segs03-tamu/ECEN404-2025SP-Fantastic-Foxbot/presentation_slides/404 Statues Update 1.pdf

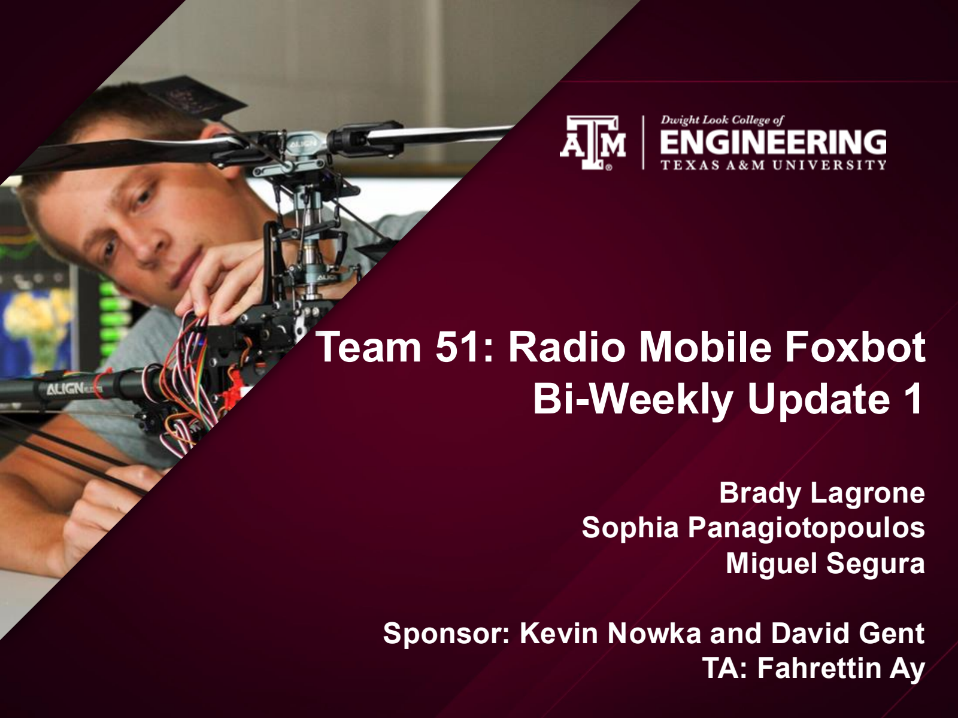
[picture p20: page 1]

# Team 51: Radio Mobile Foxbot Bi-Weekly Update 1

### Brady Lagrone Sophia Panagiotopoulos Miguel Segura

### Sponsor: Kevin Nowka and David Gent TA: Fahrettin Ay

# Project Summary

Purpose:
- Amateur Radio Directional Finding (ARDF) is traditionally done with a stationary transmitter, limiting the training abilities.
- Transmitted signals are non-adjustable with little variability for the user.
Our Proposal:
- We will have a mobile robot chassis transmitting user selected signals.
- This will increase the potential of ARDF training.

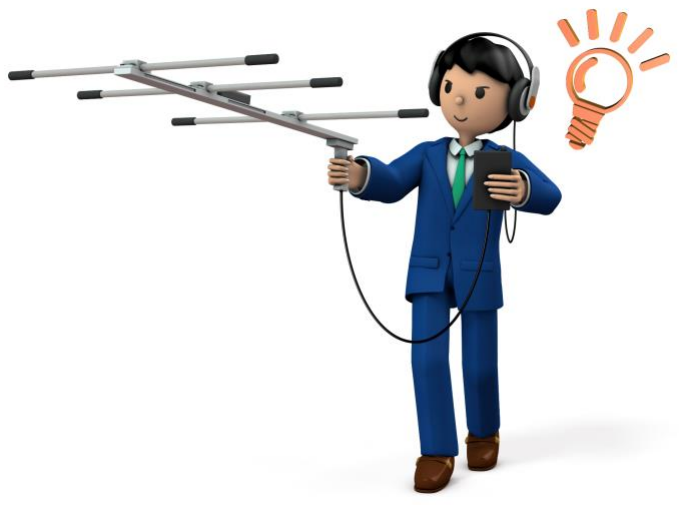
[picture p21: figure]

# Project/Subsystem Overview

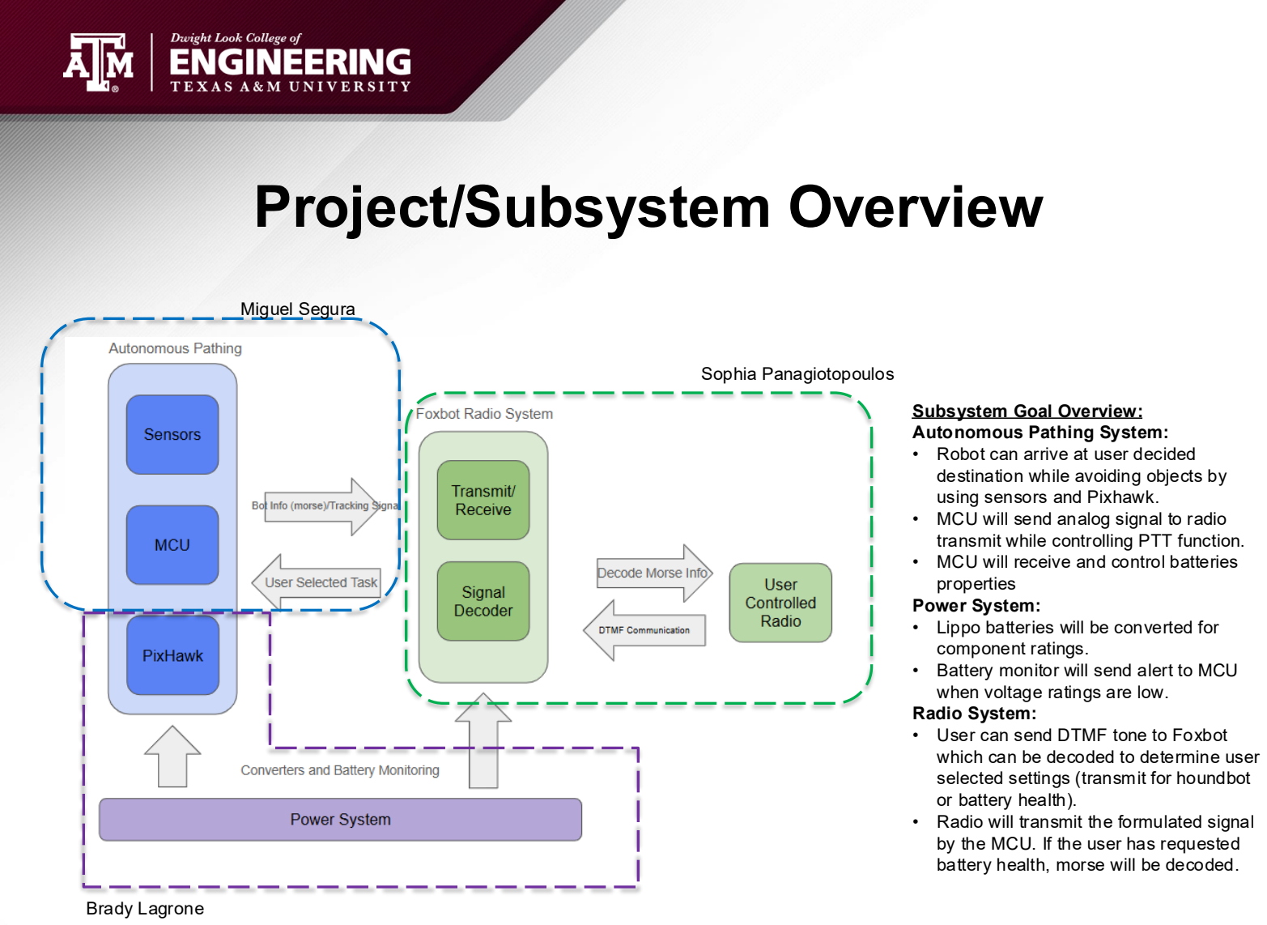
[picture p22: page 3]

Brady Lagrone

Sophia Panagiotopoulos

Miguel Segura

Subsystem Goal Overview:
Autonomous Pathing System:
- Robot can arrive at user decided destination while avoiding objects by using sensors and Pixhawk.
- MCU will send analog signal to radio transmit while controlling PTT function.
- MCU will receive and control batteries properties
Power System:
- Lippo batteries will be converted for component ratings.
- Battery monitor will send alert to MCU when voltage ratings are low.
Radio System:
- User can send DTMF tone to Foxbot which can be decoded to determine user selected settings (transmit for houndbot or battery health).
- Radio will transmit the formulated signal by the MCU. If the user has requested battery health, morse will be decoded.

# Major Project Changes for 404

Major Project Changes: Decided on using a singular ESP instead of 2
- Initially, we had an ESP for pathing and an ESP for battery monitors and radio, but interfacing the ESPs seems out of reach between system integration and our timeline.

Autonomous Pathing System:
- Motor Driver will be directly connected to the Pixhawk and not to the ESP32
- Pixhawk connects to the ESP32 to specifically read values from the ultrasonic sensors

Power System:
- Battery will be monitored by fuel gauge and will send information to and from the ESP using the SCL and SDA lines.

Radio System:
- Going to use a morse decoder app instead of trying to make one.
- Will receive battery information only, where we initially were also going to do coordinates of the Foxbot.

# Project Timeline

Completed

- Ultrasonic
sensor
programming
with ESP
- DTMF
Decoder and
transmission
circuit
- Voltage
converters for
each
component
- Mission plan
from EQUAD
to Kyle Field
- Pixhawk
interfacing
with motors
- Battery
monitor
design
- ESP code for
transmission
and battery
monitor
readings
- Integrate the
battery
monitor with
the radio
system to
transmit data
to the user
- Sensors
connected to
Pixhawk for
autonomous
pathing
Underway | Future

# MCU Subsystem

Miguel Segura

Accomplishments since 403 ~8hrs | Ongoing progress/problems and plans until the next presentation
- Reformatted and adjusted the motor control and ultrasonic sensor code that was done in 403. | • Connect Sabertooth 2x12 to the PixHawk and Mission Planner for the autonomous control. • Connect the US sensors to the PixHawk and provide functionality with the code created. • Create firmware that integrates the Radio Subsystem to the ESP32.

# MCU Subsystems

Miguel Segura

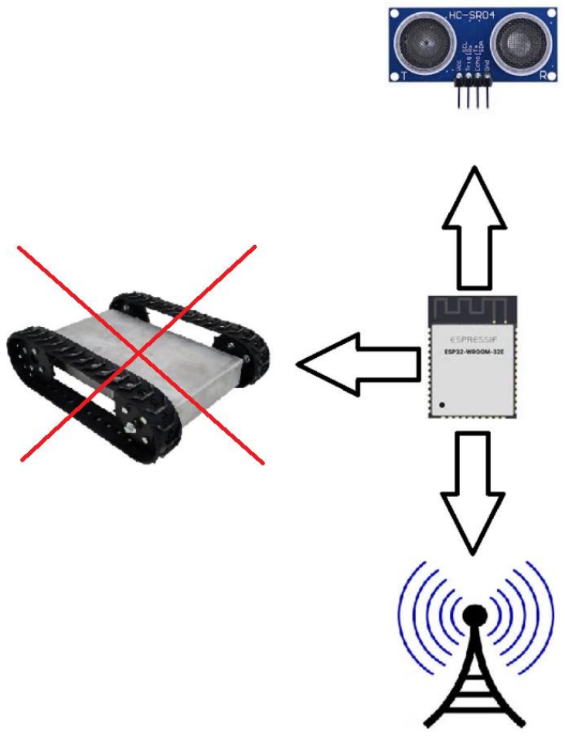
[picture p23: figure]

- ESP32 no longer directly connecting to the Foxbot's motors
- Ultrasonic sensor code
works but needs to
connect to the PixHawk.
- Code for radio/esp32
needs to be programmed
to transmit.

# Power Subsystem

Brady Lagrone

Accomplishments since 403
~15 hours

Ongoing progress/problems and plans until the next presentation
- Three step down converters (3.3V, 5.3V, 7.4V) from 11.1V are still operational from 403
- Working I2C communication (Between ESP32s for now)
- Have basic inputs to ESP32 ADC to output into morse (LED)
- Work with Radio Subsystem to connect the ESP32 dev kit to PCB and start testing binary inputs to functions
- ESP32 connect to battery fuel gauges or look into other options

# Power Subsystem

Brady Lagrone

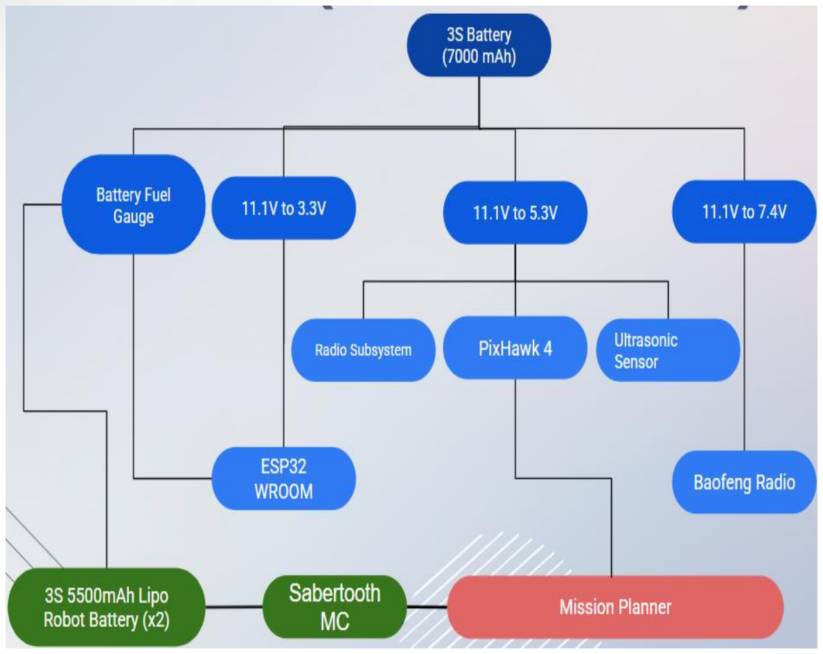
[picture p24: figure]

- Power converters all work at their respective voltage out levels and max current draws.
- Mission planner can handle control of motors.
- ESP32 has basic morse code outputs

# Radio Subsystem

Sophia Panagiotopoulos

Accomplishments since 403
~20 hrs of effort

Ongoing progress/problems and plans until the next presentation
- Decoder and transmission perform as I left it in 403; decoder properly can identify the DTMF tone sent and, PTT can be
enabled by a common ground, and the Foxbot radio can transmit to the user radio via a sinusoidal wave.
- Designed and simulated a condensed output line for easier ESP integration
- Enable PTT with a transistor, controlled by a GPIO pin.
- Send signals from DAC to user radio.
- Finalize ESP pins and map out on integrated schematic.
- Designing MUX configuration to condense I2C lines for the battery monitor integration with ESP

# Radio Subsystem Figure

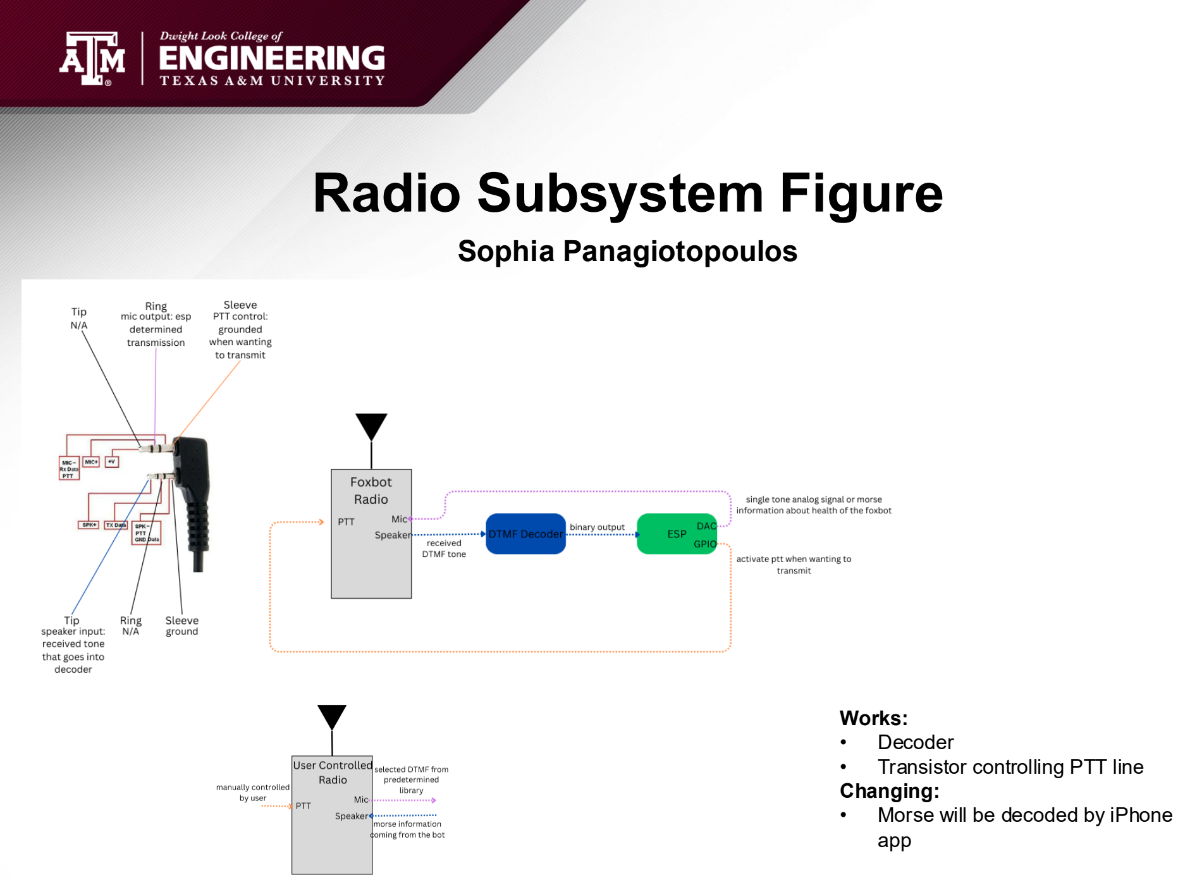
[picture p25: page 11]

Sophia Panagiotopoulos

Works:
- Decoder
- Transistor controlling PTT line Changing:
- Morse will be decoded by iPhone app

# Parts Ordering Status

- Working on making the integrated PCB and plan to get that finished by early February.
- Assembly will start once all parts have come in

# Validation Plan

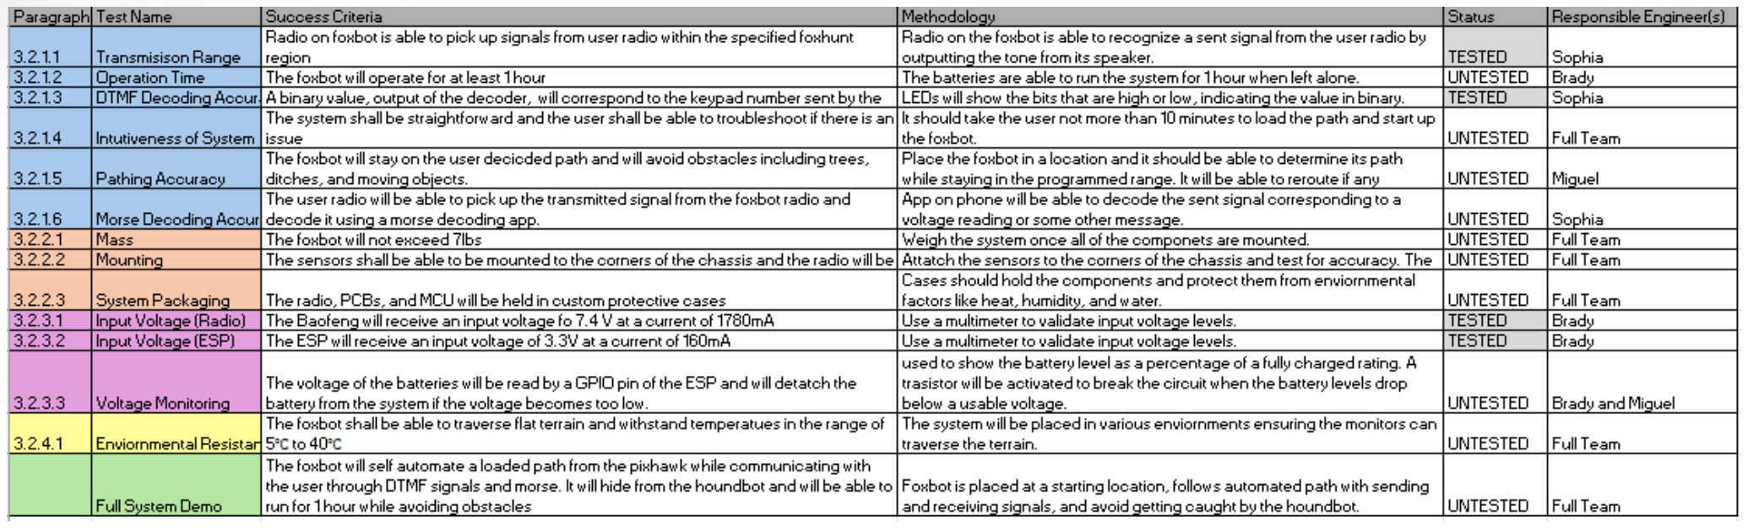
[picture p26: figure]

# Gantt Chart

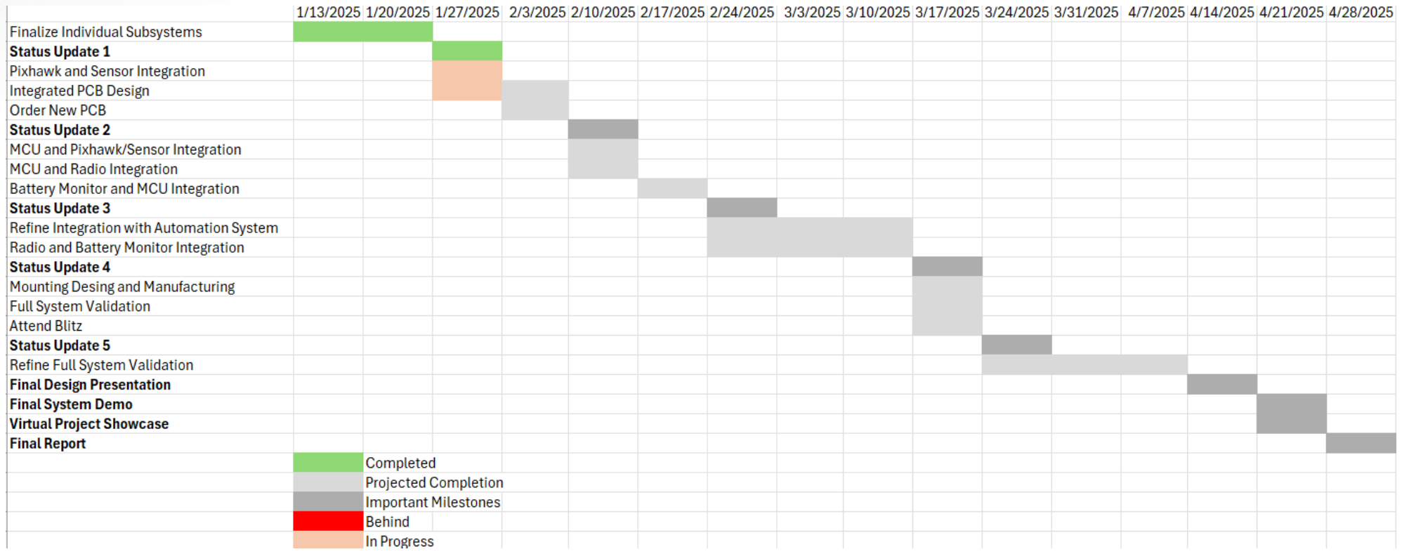
[picture p27: figure]
