segs03-tamu/ECEN404-2025SP-Fantastic-Foxbot/presentation_slides/404 Status Update 2.pdf

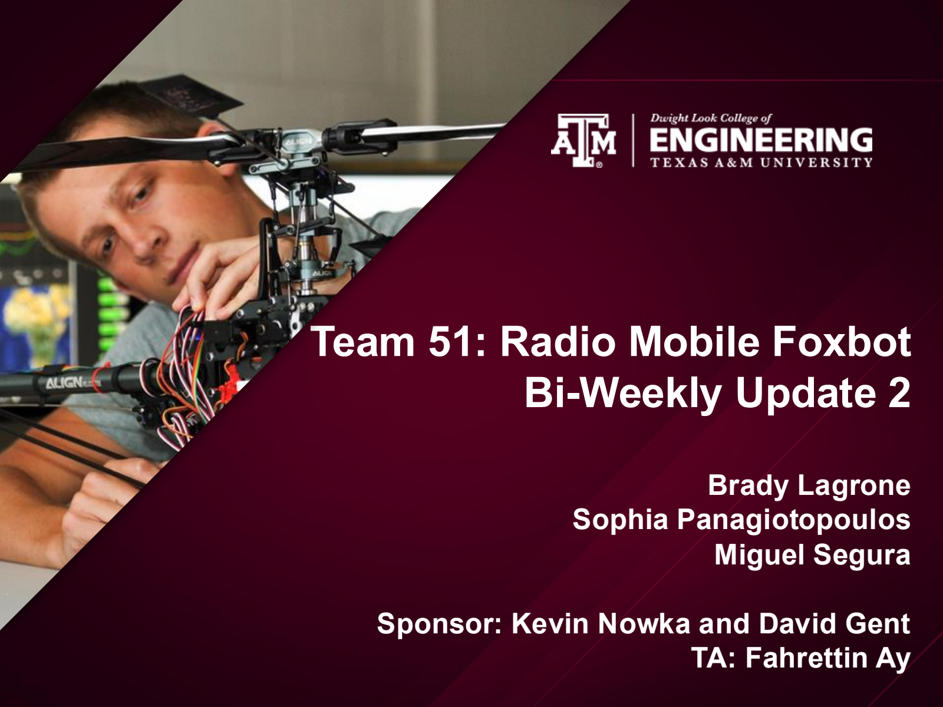
[picture p28: page 1]

# Team 51: Radio Mobile Foxbot Bi-Weekly Update 2

### Brady Lagrone Sophia Panagiotopoulos Miguel Segura

### Sponsor: Kevin Nowka and David Gent TA: Fahrettin Ay

- Purpose:
- Amateur Radio Directional Finding (ARDF) is traditionally done with a stationary transmitter, limiting the training abilities.
- Transmitted signals are non-adjustable with little variability for the user.
- Our Proposal:
- We will have a mobile robot chassis transmitting user selected signals.
- This will increase the potential of ARDF training.

# Project Summary

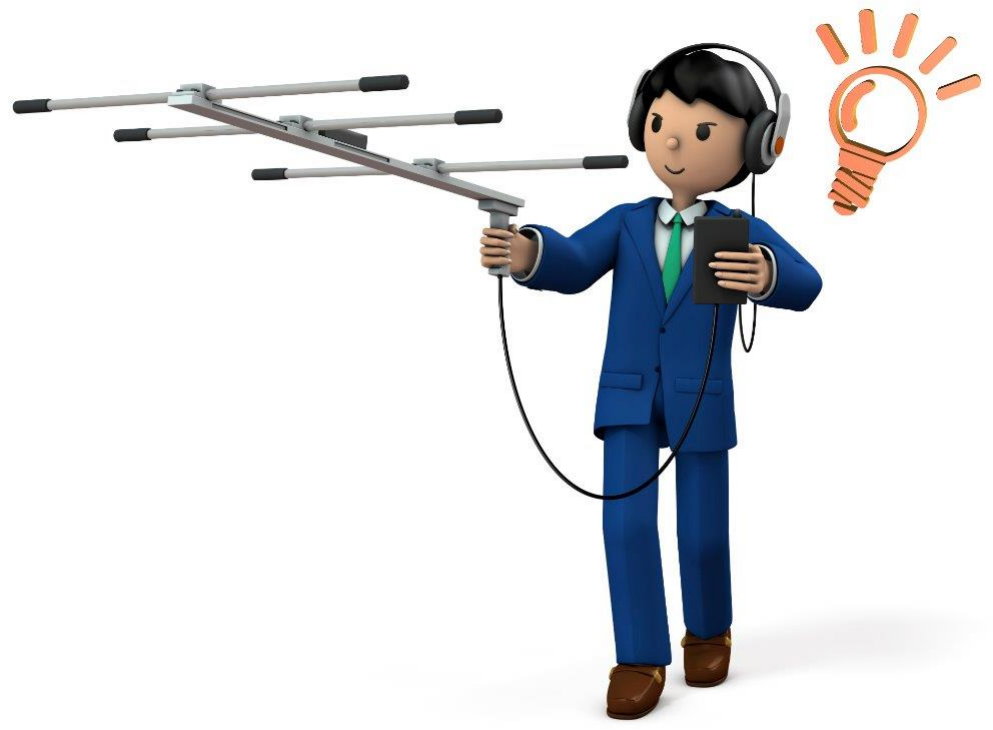
[picture p29: figure]

# Project/Subsystem Overview


Brady Lagrone

Sophia Panagiotopoulos

Miguel Segura

Subsystem Goal Overview:
Autonomous Pathing System:
- Robot can arrive at user decided destination while avoiding objects by using sensors and Pixhawk.
- MCU will send analog signal to radio transmit while controlling PTT function.
- MCU will receive and control batteries properties
Power System:
- Lippo batteries will be converted for component ratings.
- Battery monitor will send alert to MCU when voltage ratings are low.
Radio System:
- User can send DTMF tone to Foxbot which can be decoded to determine user selected settings (transmit for houndbot or battery health).
- Radio will transmit the formulated signal by the MCU. If the user has requested battery health, morse will be decoded.

# Project Timeline

Subsystem
Designs and
Testing
(completed
01/27)

Integration of
power and
radio
subsystem
PTT
(completed
2/9)

Integration of
MCU and
Motor Driver
(to complete
by 2/14)

Integration of
power and
radio ADC
(to complete
by 2/14)

Final
Integration(to
complete by
3/7)

System
Testing (to be
completed
3/17)

Demo and
Report
(to complete
by 4/14)

# MCU Subsystem

Miguel Segura

Accomplishments since last update ~16 hrs of effort

Ongoing progress/problems and plans until the next presentation

- Armed the PixHawk to Mission Planner to provide the
autonomous design.
- Wrote code to make LEDs
interact as "motors" to measure their PWM signal from Mission Planner through the PixHawk.
- Integrate PixHawk to Sabertooth and perform test runs through Mission Planner
- Further develop simulation protocol and get functionality across the system.

# MCU Subsystem

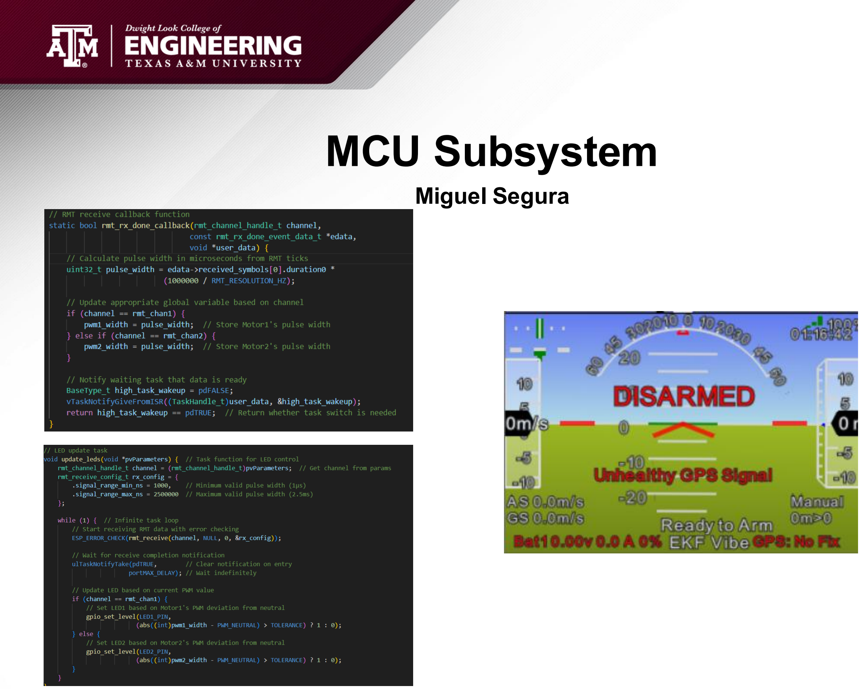
[picture p30: page 6]

Miguel Segura

# Power Subsystem

Brady Lagrone

Accomplishments since last update 30 hrs of effort

Ongoing progress/problems and plans until the next presentation
- Established I2C communication with BQ7692003PWR battery
monitor
- Wrote and tested code for the ADC detecting levels 0-9, for integrating with the radio subsystem
- Wrote code for to produce morse code from the generated sine wave, and tested and integrated with radio subsystem
- Continue and finish PCB
integration between power and radio subsystem
- Establish more modes of
operation according to digits pressed

# Power Subsystem

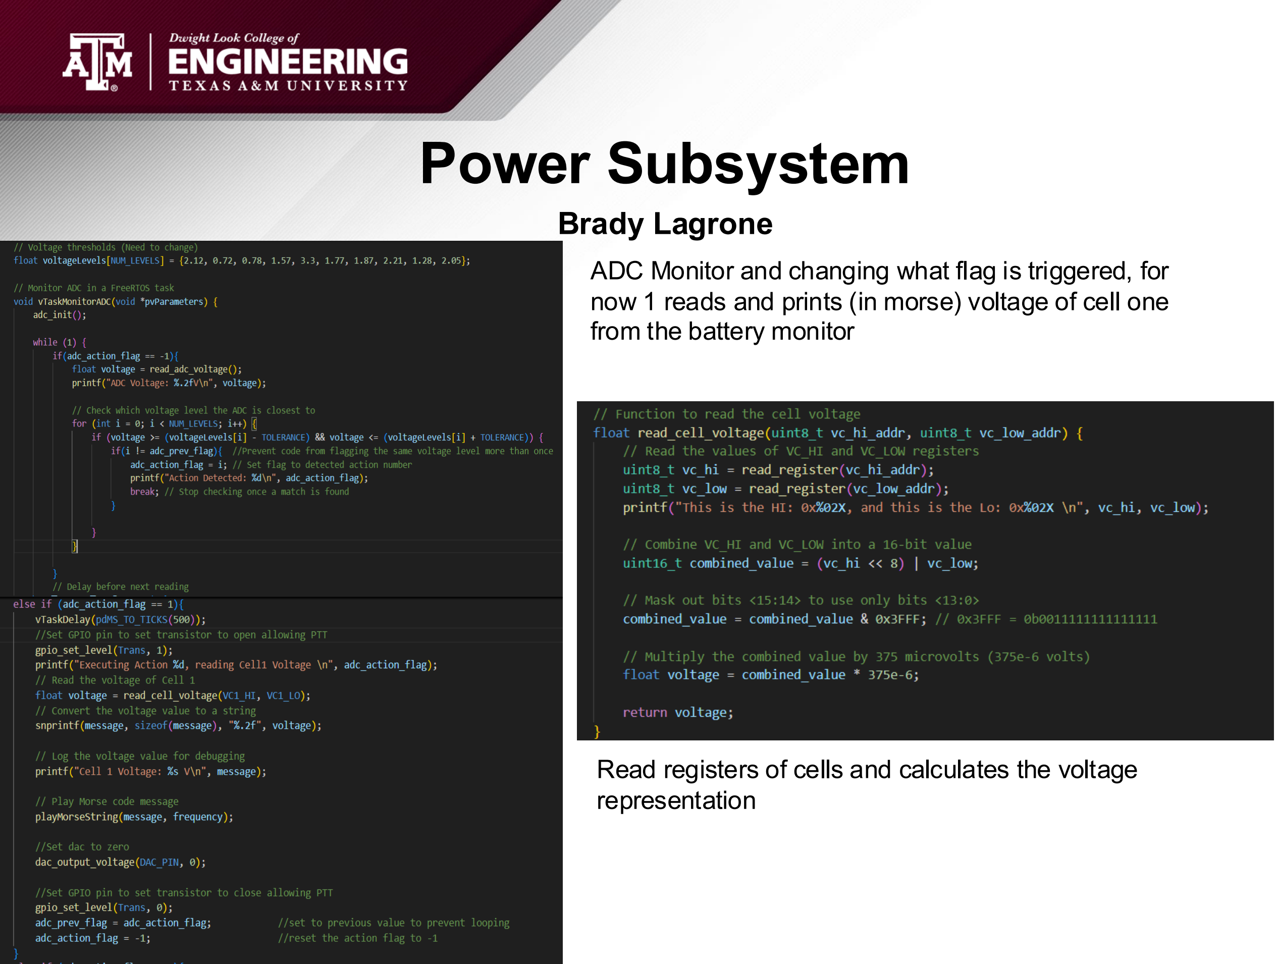
[picture p31: page 8]

Brady Lagrone

ADC Monitor and changing what flag is triggered, for now 1 reads and prints (in morse) voltage of cell one from the battery monitor

Read registers of cells and calculates the voltage representation

# Radio Subsystem

Sophia Panagiotopoulos

Accomplishments since last update 30 hours of effort

Ongoing progress/problems and plans until the next presentation
- Completed a bit weighted voltage divider to minimize pins
needed from the ESP with the ADC being able to recognize different tones sent.
- Coded a sine wave generator for the DAC that can transmit when a voltage is read from the ADC, allowing for radio transmission and MCU integration.
- PTT is enabled by IO pin when ADC reads a value and DAC
wants to transmit.
- Work on shutting down decoder board when PTT is enabled
through something like a high-side driver circuit or op-amp.
- Refine voltage divider since some values are too close for the ESP to differentiate between.

# Radio Subsystem Figure

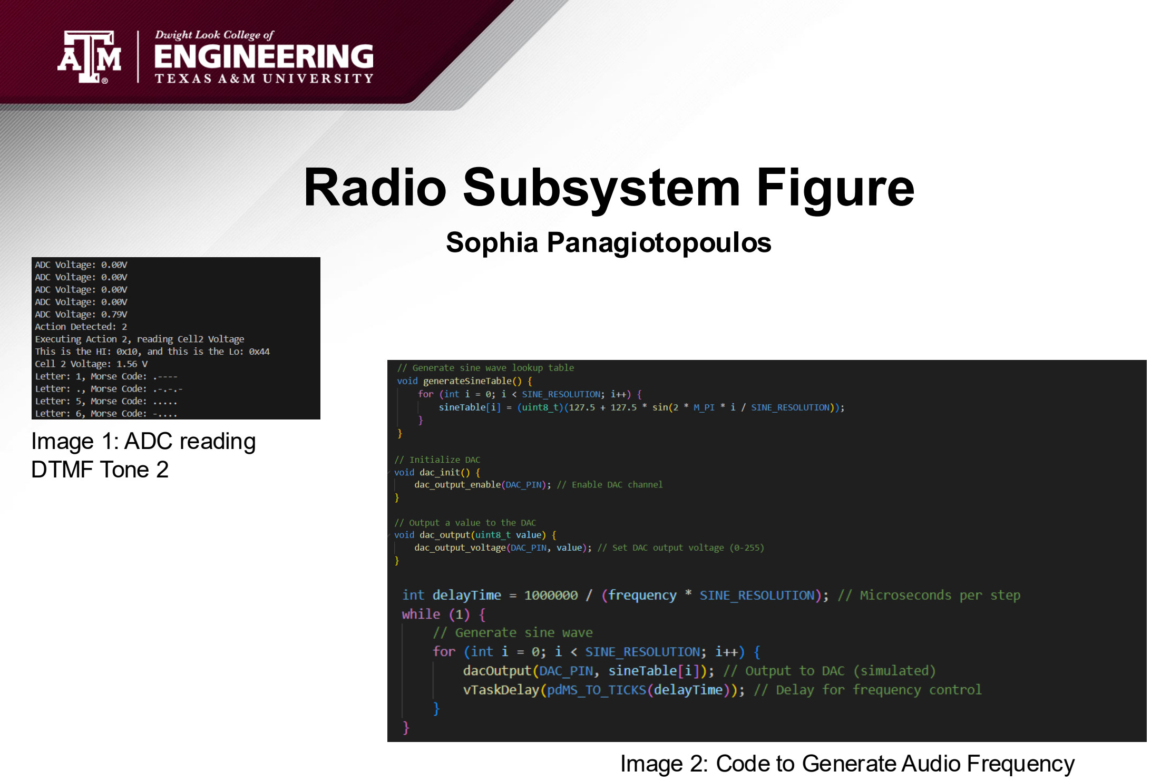
[picture p32: page 10]

Sophia Panagiotopoulos

Image 1: ADC reading
DTMF Tone 2

Image 2: Code to Generate Audio Frequency

# Validation Plan


# Gantt Chart

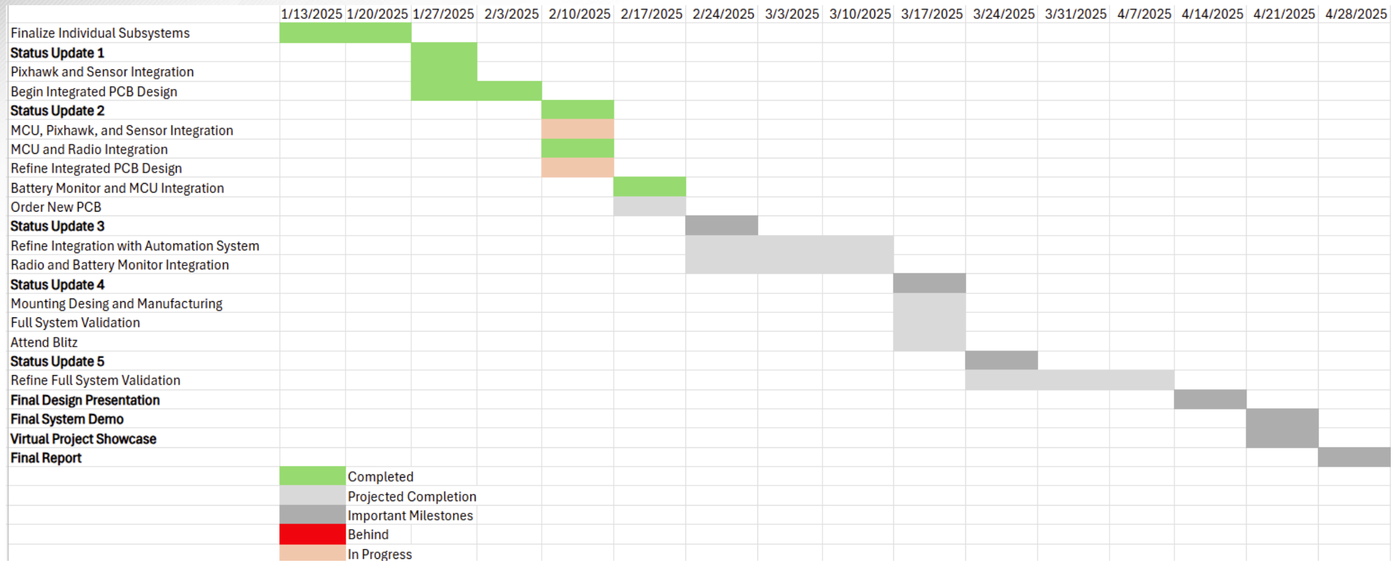
[picture p33: figure]
