segs03-tamu/ECEN404-2025SP-Fantastic-Foxbot/presentation_slides/404 Status Update 3.pdf

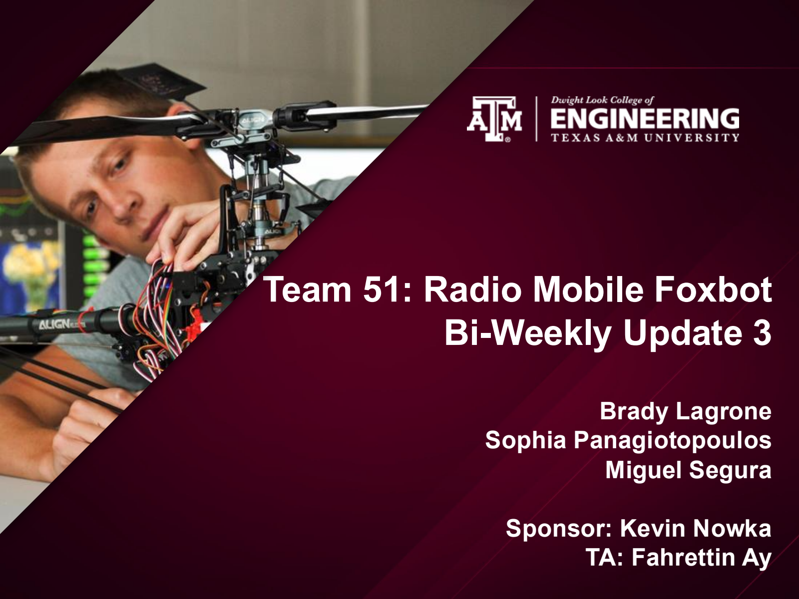
[picture p34: page 1]

# Team 51: Radio Mobile Foxbot Bi-Weekly Update 3

## Brady Lagrone Sophia Panagiotopoulos Miguel Segura

## Sponsor: Kevin Nowka TA: Fahrettin Ay

# Project Summary

## Purpose:

### - Amateur Radio Directional Finding


### (ADRF) is a sport in which an individual tries to locate a hidden transmitting device. Our goal is to

“hide” from an adversary Houndbot, who will be trying to locate our robot.

### Additionally, our robot will increase the potential of ARDF training and aid in the engineering of directional

antennas.

## Proposal:

### - We have created a radio system

### coupled with a mobile robot that receives DTMF signals and preforms various functions based on the

decoded signal.

# Project/Subsystem Overview


Brady Lagrone

Sophia Panagiotopoulos

Miguel Segura

Subsystem Goal Overview:
Autonomous Pathing System:
- Robot can arrive at user decided destination while avoiding objects by using sensors and Pixhawk.
- MCU will send analog signal to radio transmit while controlling PTT function.
- MCU will receive and control batteries properties
Power System:
- Lippo batteries will be converted for component ratings.
- Battery monitor will send alert to MCU when voltage ratings are low.
Radio System:
- User can send DTMF tone to Foxbot which can be decoded to determine user selected settings (transmit for houndbot or battery health).
- Radio will transmit the formulated signal by the MCU. If the user has requested battery health, morse will be decoded.

# Project Timeline

Subsystem
Designs and
Testing
(completed
01/27)

Integration of
power and
radio
subsystem
PTT
(completed
2/9)

Integration of
MCU and
Motor Driver
(to complete
by 2/14)

Integration of
power and
radio ADC
(to complete
by 2/14)

All systems
have been
integrated
(to complete
by 3/7)

System
Testing (to be
completed
3/17)

Demo and
Report
(to complete
by 4/14)

### Accomplishments since last update ~17hrs

### Ongoing progress/problems and plans until the next presentation

- ESP32 code developed to arm PixHawk and verified to work with tonal system
- MavLink autonomous base design coded to connect ESP32 to PixHawk to control Motor Controllers
- Continued issues integrating the GPS system of PixHawk with ESP32 (Unable to parse GPS coordinates from MavLink)
- Finalize integration with ESP32 with PixHawk (one successful design path)
- Integrate the PixHawk with Radio/Power Subsystems

# MCU Subsystem

### Miguel Segura

# MCU Subsystem

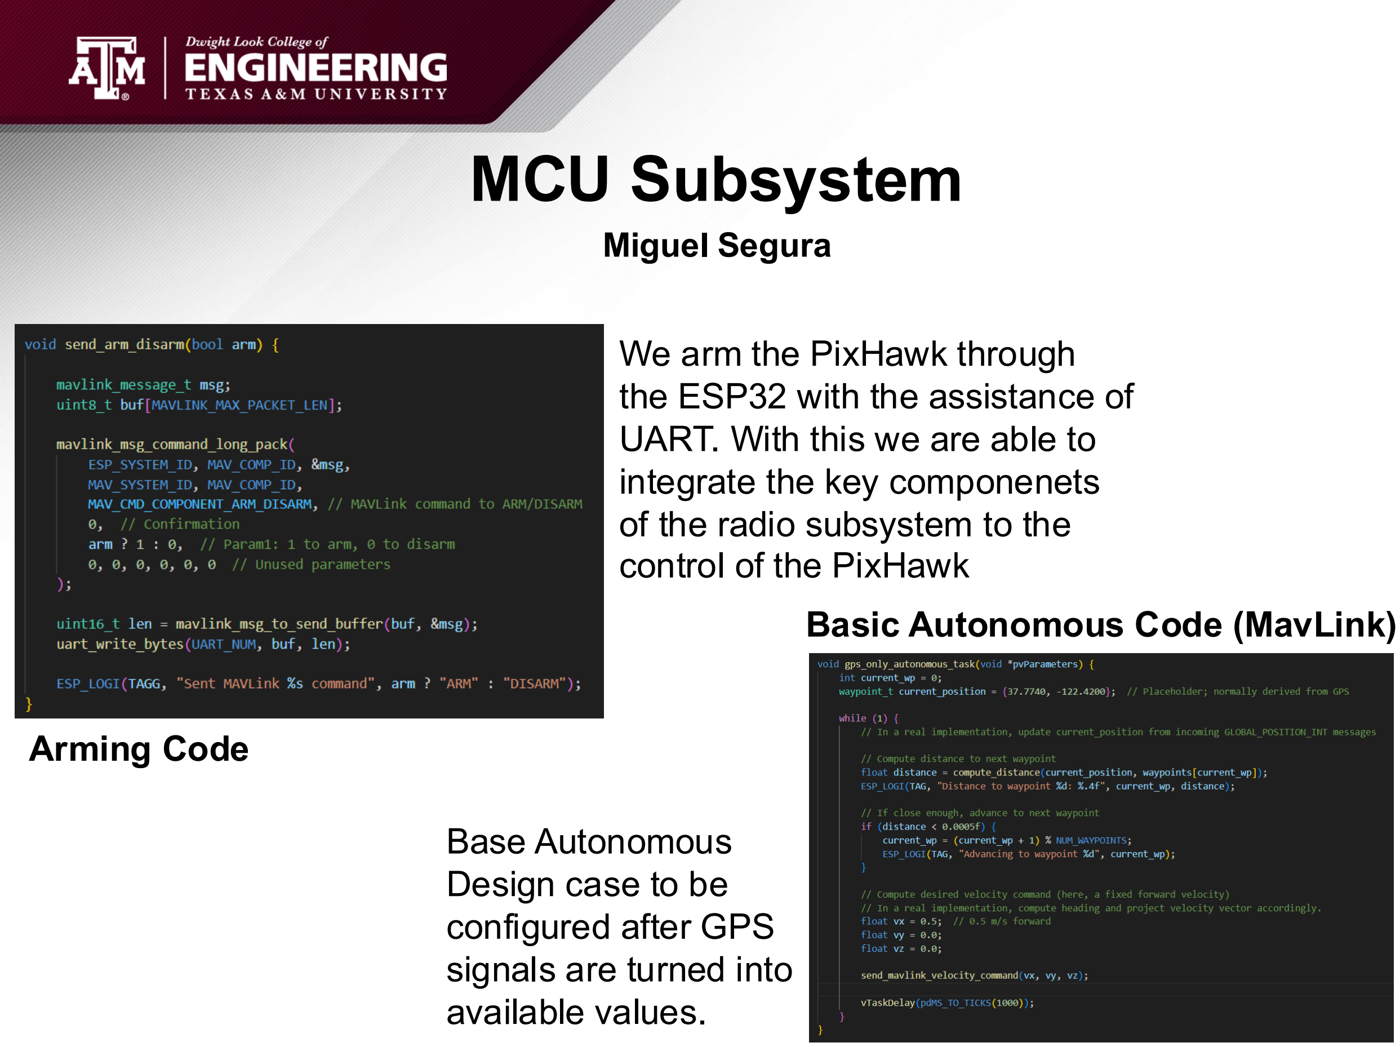
[picture p35: page 6]

### Miguel Segura

### Arming Code

### We arm the PixHawk through the ESP32 with the assistance of UART. With this we are able to integrate the key componenets of the radio subsystem to the control of the PixHawk

### Basic Autonomous Code (MavLink)

### Base Autonomous Design case to be configured after GPS signals are turned into

available values.

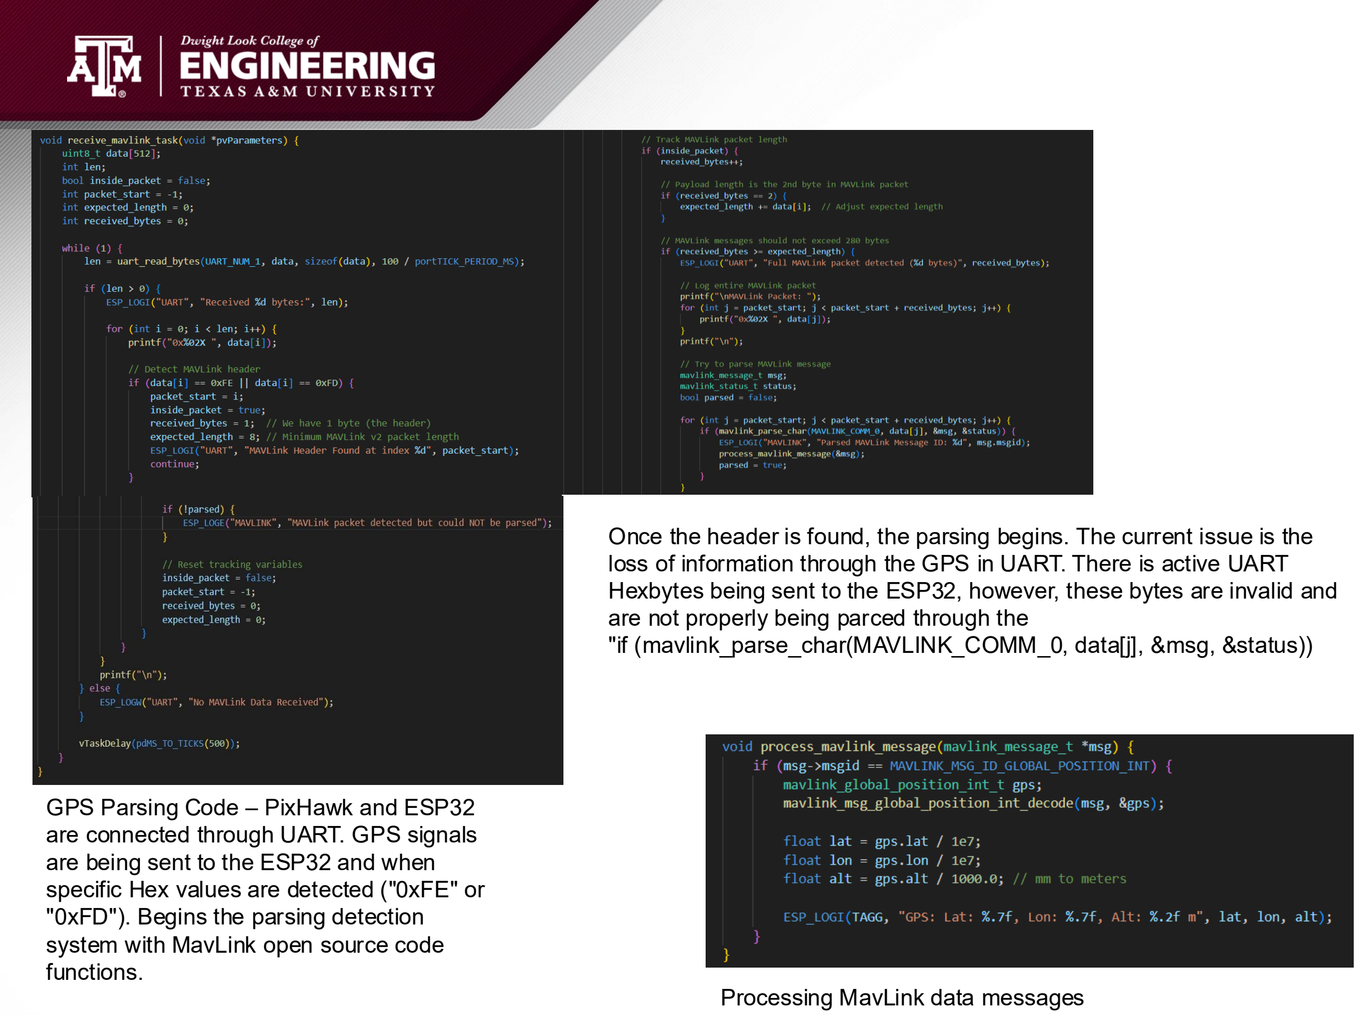
[picture p36: page 7]

GPS Parsing Code – PixHawk and ESP32 are connected through UART. GPS signals are being sent to the ESP32 and when specific Hex values are detected ("0xFE" or "0xFD"). Begins the parsing detection system with MavLink open source code functions.
Processing MavLink data messages

Once the header is found, the parsing begins. The current issue is the loss of information through the GPS in UART. There is active UART Hexbytes being sent to the ESP32, however, these bytes are invalid and are not properly being parced through the
"if (mavlink_parse_char(MAVLINK_COMM_0, data[j], &msg, &status))

### Accomplishments since last update 30 hrs of effort

### Ongoing progress/problems and plans until the next presentation

- ESP receives and responds to walkie talkie dial tone in FEDC lab (~50 ft)
- ESP GPIO PTT works turning off and on when GPIO is triggered
- Removed static noise from DAC morse through radio
- Integration between Radio and ESP system complete (breadboard)
- On going integration with Pixhawk and ESP/Radio System
- Finish soldering and test PCB for full functionality
- Integrate with Pixhawk system with ESP
- Begin testing functionality of system (transmitting, driving and transmitting, stopping and going)

# Power Subsystem

### Brady Lagrone

Dial Tone flag | PTT Circuit

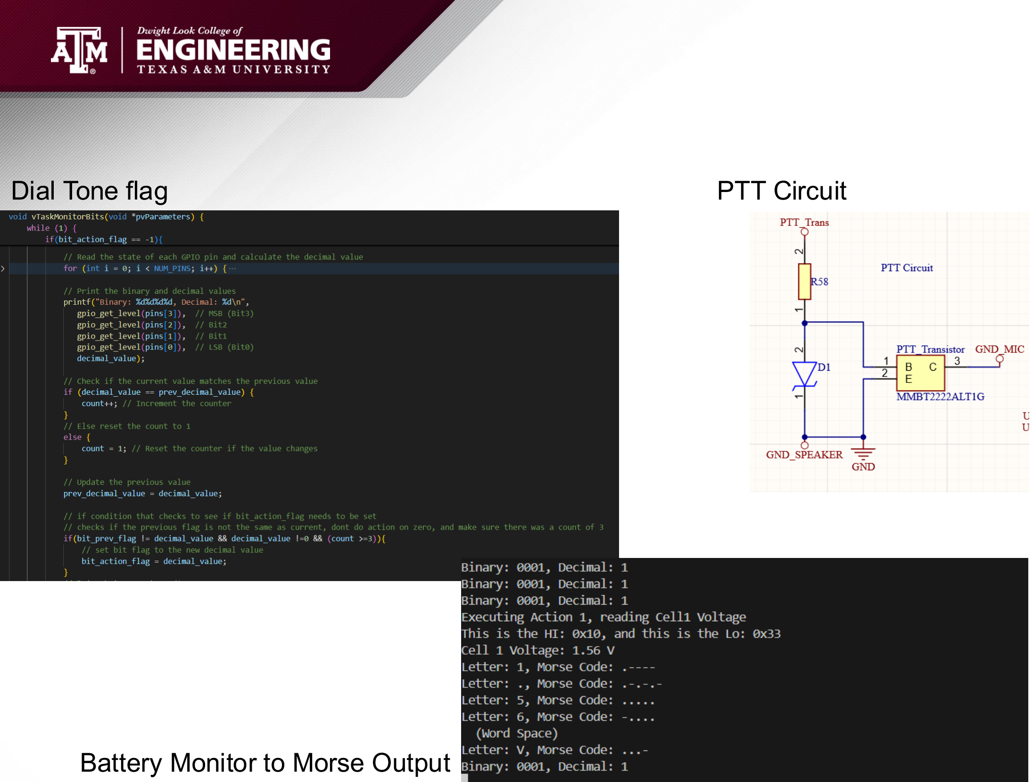
[picture p37: page 9]

### Interesting figure showing functional integrated subsystems

### Best to show: Integration results and Functional system

testing results for what has been integrated.

### Battery Monitor to Morse Output

### Accomplishments since last update 30 hours of effort

### Ongoing progress/problems and plans until the next presentation

- Ordered the integrated PCB and began soldering components.

Mostly completed integration with the power system:
- Debugged Radio/MCU system with Brady, eliminating PTT bug that was causing the radio to always be in PTT.
- Fine-tuned functional code block.
- Tested for decoding (input) and morse (output) range
- Finish soldering PCB and begin testing all circuits for intended functionality
- Any autonomous pathing control using DTMF tones
- Integrate with the motor control system so that the robot can be stopped by certain DTMF tones (allowing the ESP to overtake the PixHawk)
- Map certain tones to motor functionality and gps information
- Begin testing outside for further ranges

# Radio Subsystem

### Sophia Panagiotopoulos

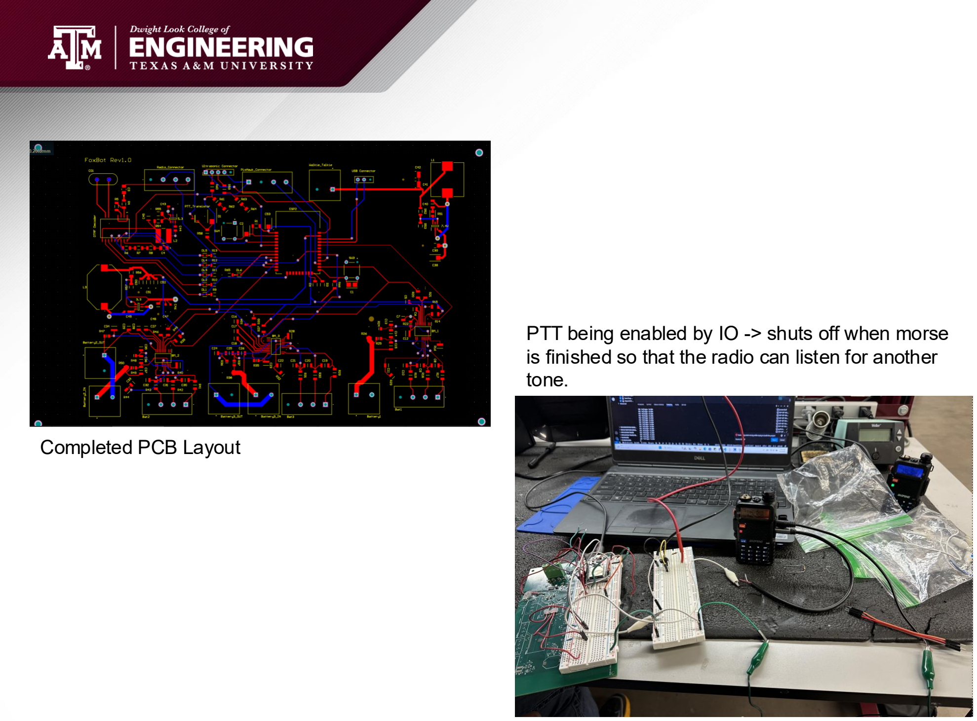
[picture p38: page 11]

Completed PCB Layout

PTT being enabled by IO -> shuts off when morse is finished so that the radio can listen for another tone.

# Validation Plan


# Gantt Chart

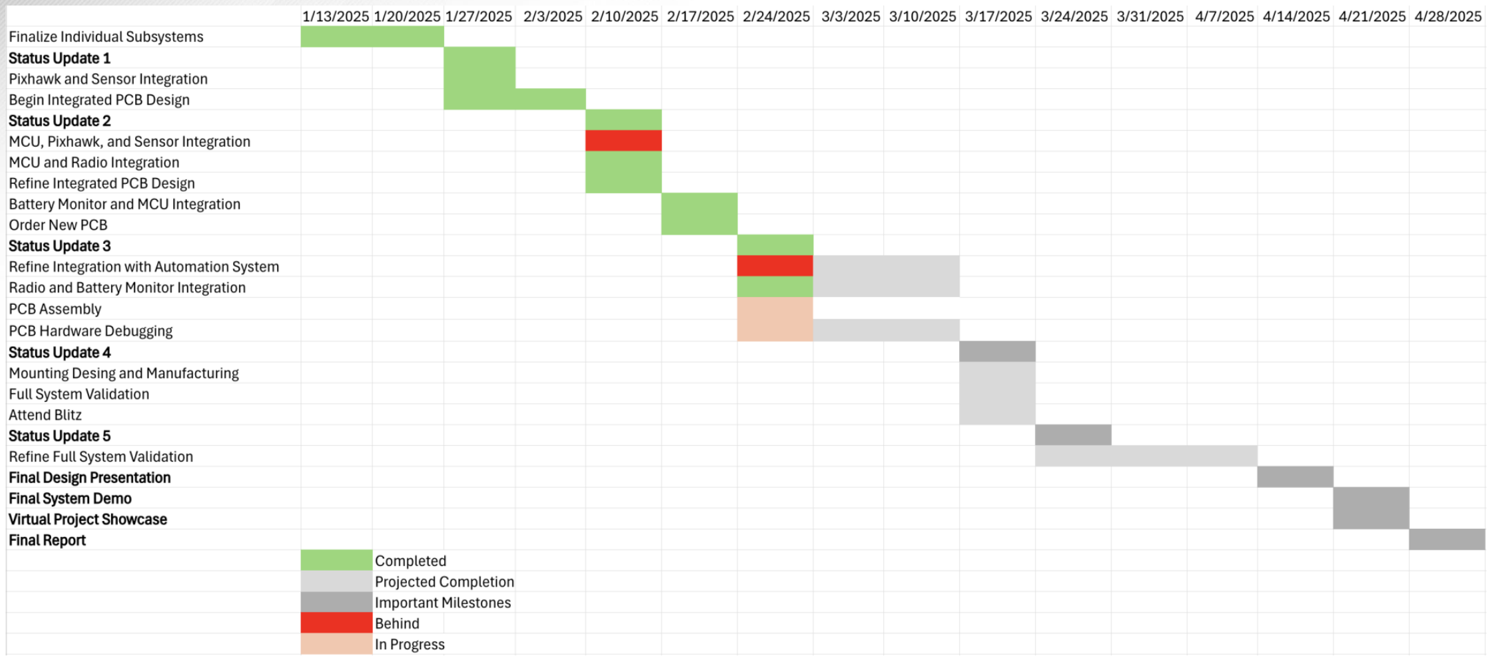
[picture p39: figure]
