segs03-tamu/ECEN404-2025SP-Fantastic-Foxbot/presentation_slides/404 Status Update 4.pdf

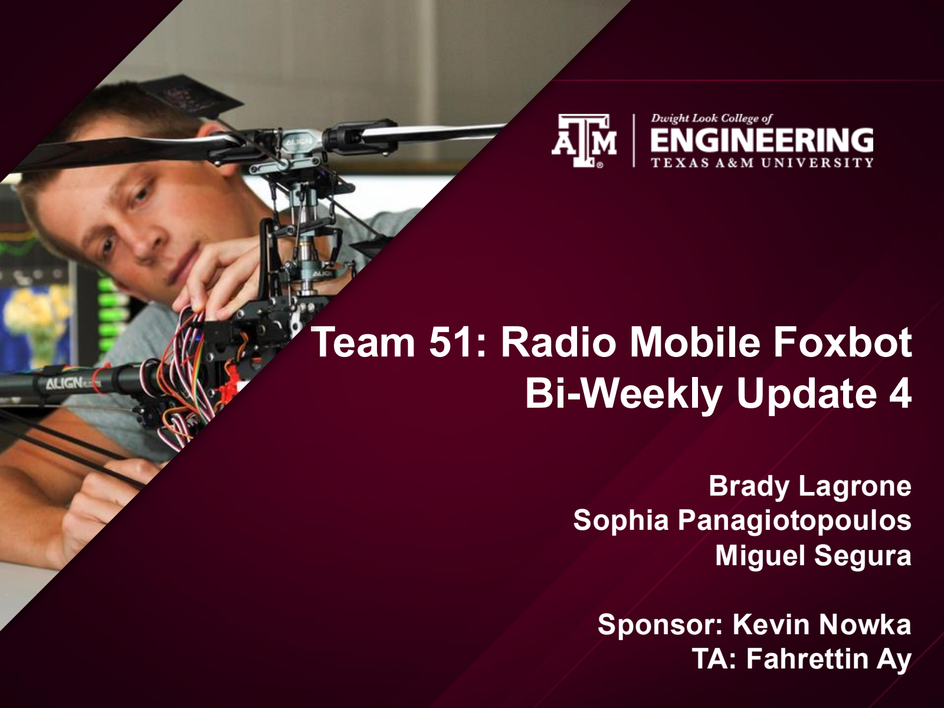
[picture p40: page 1]

# Team 51: Radio Mobile Foxbot Bi-Weekly Update 4

### Brady Lagrone Sophia Panagiotopoulos Miguel Segura

### Sponsor: Kevin Nowka TA: Fahrettin Ay

# Project Summary

### Purpose:

- Amateur Radio Directional Finding (ADRF) is a sport in which an individual tries to locate a hidden transmitting device. Our goal is to “hide” from an adversary Houndbot, who will be trying to locate our robot. Additionally, our robot will increase the potential of ARDF training and aid in the engineering of directional antennas.


### Proposal:

- We have created a radio system coupled with a mobile robot that receives DTMF signals and preforms various functions based on the decoded signal.

# Integrated System Diagram

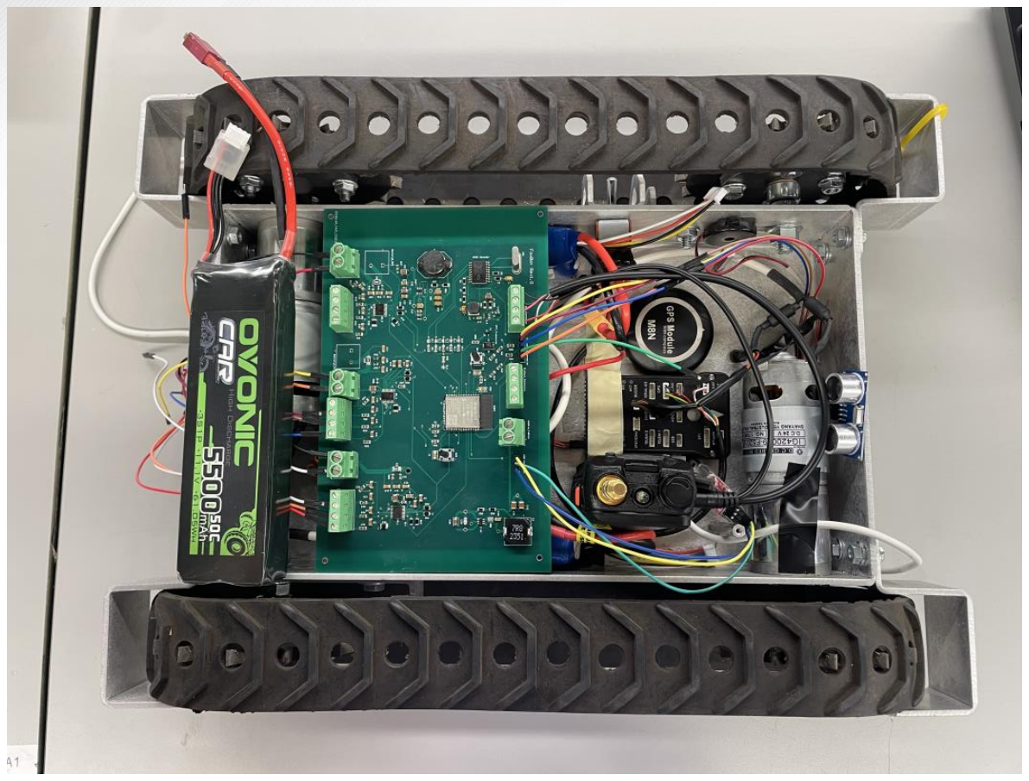
[picture p41: figure]

- PCB, Radio, and PixHawk
general layout integration
- The 5500mAh battery will be placed below PCB in
final design with casing
made to hold the other
internals that consist of the Radio, UltraSonic Sensors
Mounts, and GPS Mount.
- Wires will be sorted and changed with finalized
integration of design.

# Project Timeline

Subsystem
Designs and
Testing
(completed
01/27)

Integration of
power and
radio
subsystem
PTT
(completed
2/9)

Integration of
MCU and
Motor Driver
(to complete
by 2/14)

Integration of
power and
radio ADC
(to complete
by 2/14)

All systems
have been
integrated
(to complete
by 3/7)

System
Testing (to be
completed
3/17)

Demo and
Report
(to complete
by 4/14)

# Miguel Segura

Accomplishments since last update 25 hrs of effort

Ongoing progress/problems and plans until the next presentation

- Configured proper parameter values to setup into AutoPilot Mode.
- Integrated Motors, PixHawk, and ESP32 with each other to have basic communication with each other.
- PixHawk fully controls motors with the ESP32 working as a Ground Controller.
- Planned each mode of operation with the components needed (with Brady)
- Made "mission planner" functions to have the ESP32 working as the Ground Controller.
- AutoPilot works; however, the GPS seems to be having issues with buildings obstructing the Misson Planned path. Further testing needs to be done in an area with less obstruction.
- Implement the designated modes we have determined. Alongside the radio transmission schedule.

# Miguel Segura

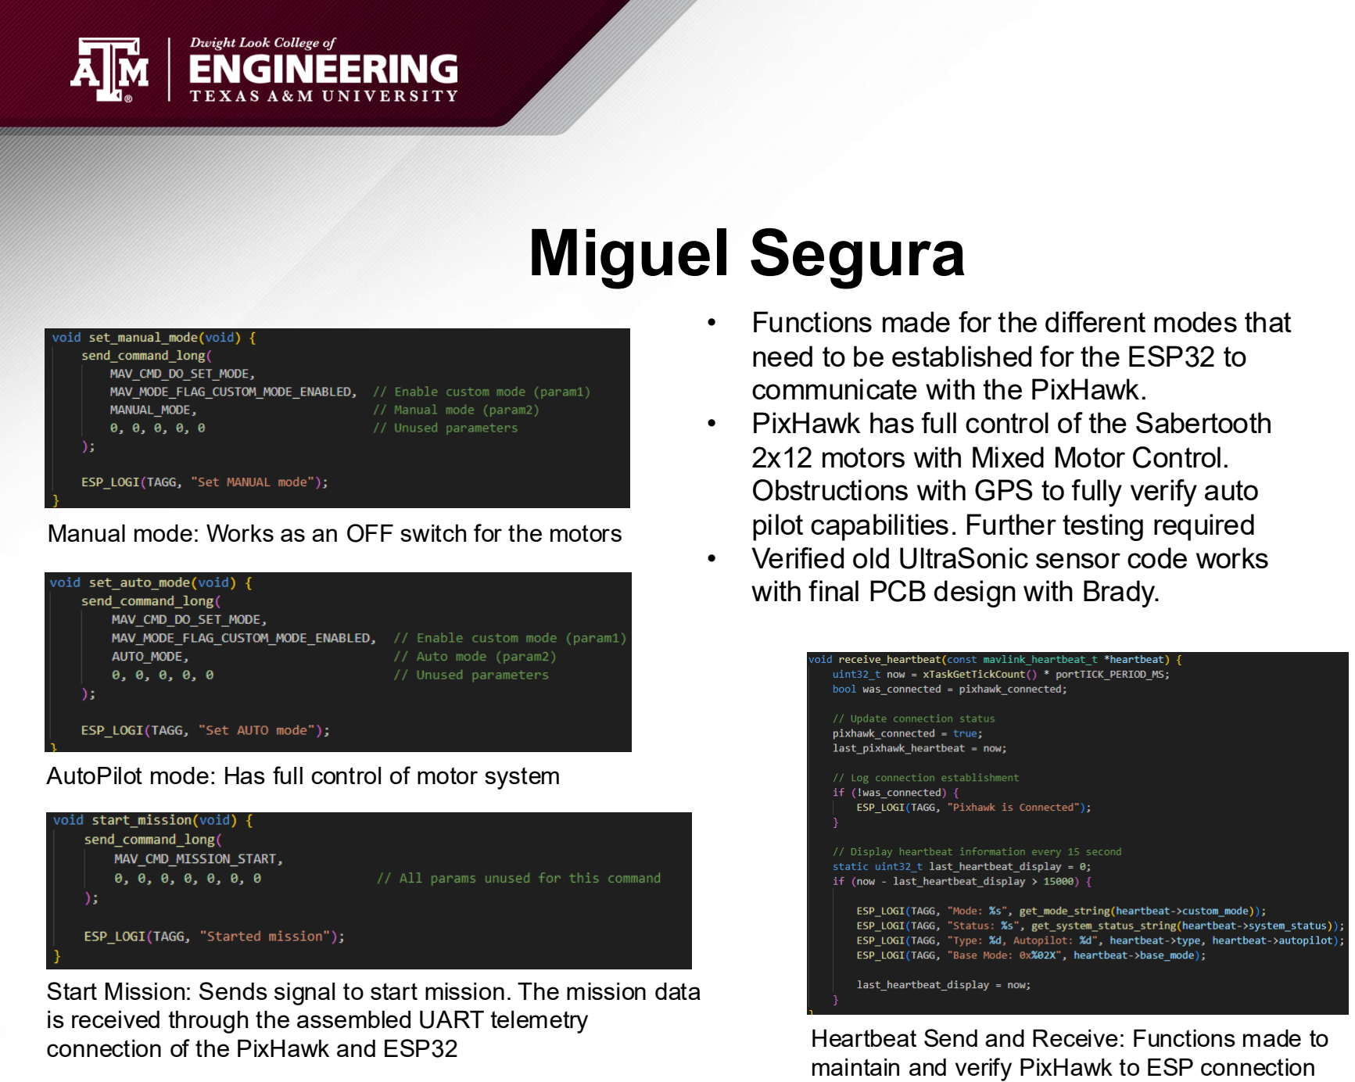
[picture p42: page 6]

- Functions made for the different modes that need to be established for the ESP32 to communicate with the PixHawk.
- PixHawk has full control of the Sabertooth 2x12 motors with Mixed Motor Control. Obstructions with GPS to fully verify auto pilot capabilities. Further testing required
- Verified old UltraSonic sensor code works with final PCB design with Brady.

Manual mode: Works as an OFF switch for the motors

AutoPilot mode: Has full control of motor system

Start Mission: Sends signal to start mission. The mission data
is received through the assembled UART telemetry
connection of the PixHawk and ESP32 | Heartbeat Send and Receive: Functions made to
| maintain and verify PixHawk to ESP connection

# Brady Lagrone

Accomplishments since last update 20 hrs of effort

Ongoing progress/problems and plans until the next presentation
- All components powered and operate on built converters
- Intgrated radio DTMF of startup and mode selection with ESP
- Finished integration of status mode of operation
- Planned each mode of
operation with the components needed
- Radio and ESP integration with Pixhawk pathing and control
- PCB configuration and
connections
- Developing each mode of
operation

# Brady Lagrone

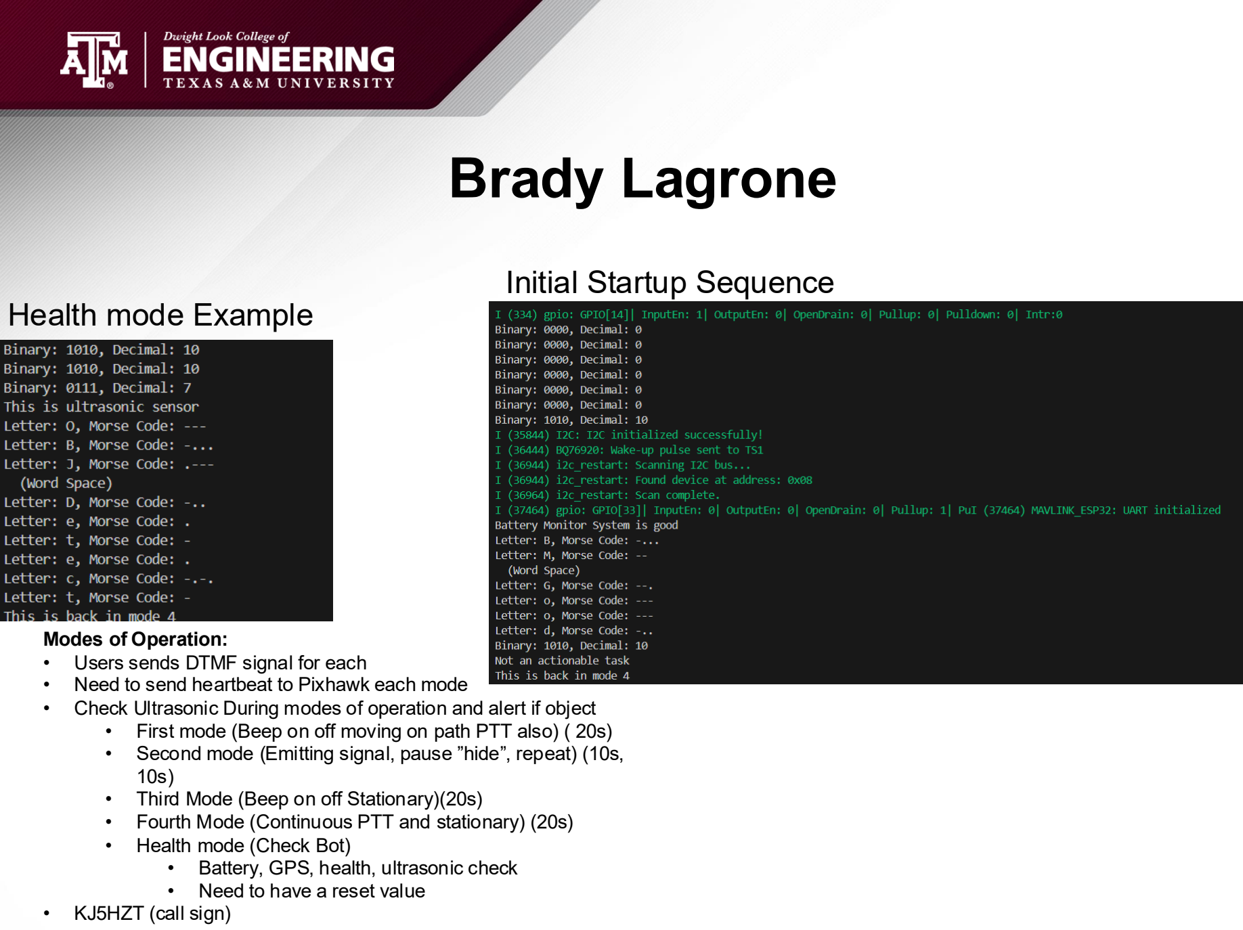
[picture p43: page 8]

Modes of Operation:
- Users sends DTMF signal for each
- Need to send heartbeat to Pixhawk each mode
- Check Ultrasonic During modes of operation and alert if object
- First mode (Beep on off moving on path PTT also) ( 20s)
- Second mode (Emitting signal, pause ”hide”, repeat) (10s, 10s)
- Third Mode (Beep on off Stationary)(20s)
- Fourth Mode (Continuous PTT and stationary) (20s)
- Health mode (Check Bot)
- Battery, GPS, health, ultrasonic check
- Need to have a reset value
- KJ5HZT (call sign)

Initial Startup Sequence
Health mode Example

# Sophia Panagiotopoulos

Accomplishments since last update 20 hrs of effort

Ongoing progress/problems and plans until the next presentation

- Finished soldering PCB and testing that all circuits are functional.
- Radio can arm and disarm the Pixhawk, beginning motor integration
- Tested radio control outside for arming and disarming Pixhawk and for reading battery health.
- Made 3D printed battery connector for radio to enable charging through the PCB.
- Made 3D printed cover for robot chassis and PCB case
- Continue working integrating radio with Pixhawk for motor control.
- Finalize modes of operation.
- Test system outside, making sure that GPS can be read.
- Test battery connection between printed part and 7.4V line.
- Continue implementing packaging for PCB and overall robot chassis.

# Sophia Panagiotopoulos

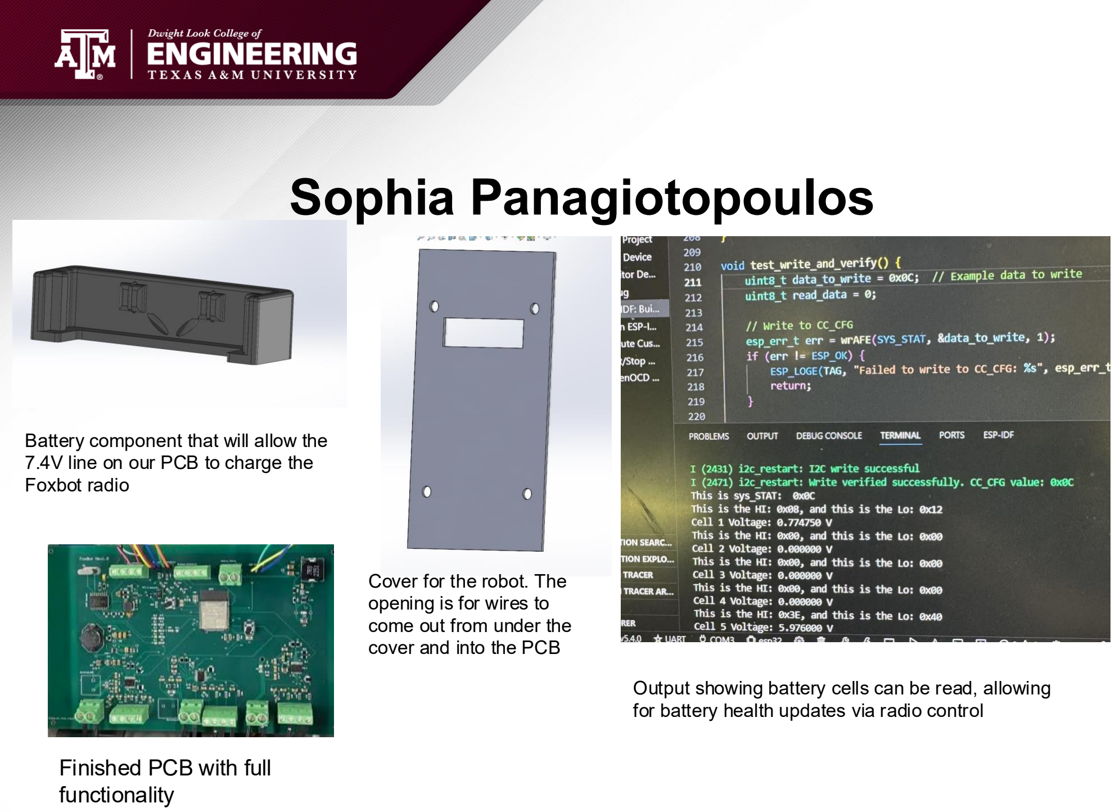
[picture p44: page 10]

Battery component that will allow the 7.4V line on our PCB to charge the Foxbot radio

Cover for the robot. The
opening is for wires to
come out from under the
cover and into the PCB

Output showing battery cells can be read, allowing for battery health updates via radio control

Finished PCB with full
functionality

# Execution Plan

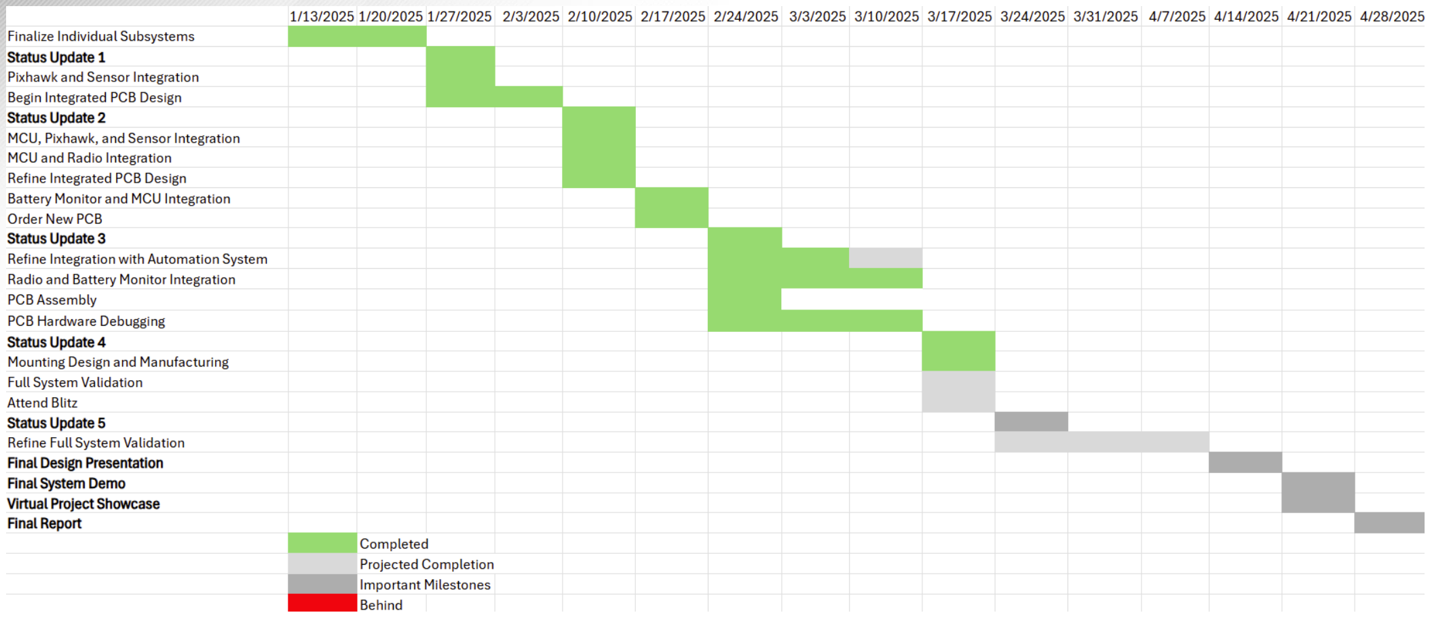
[picture p45: figure]

# Validation Plan

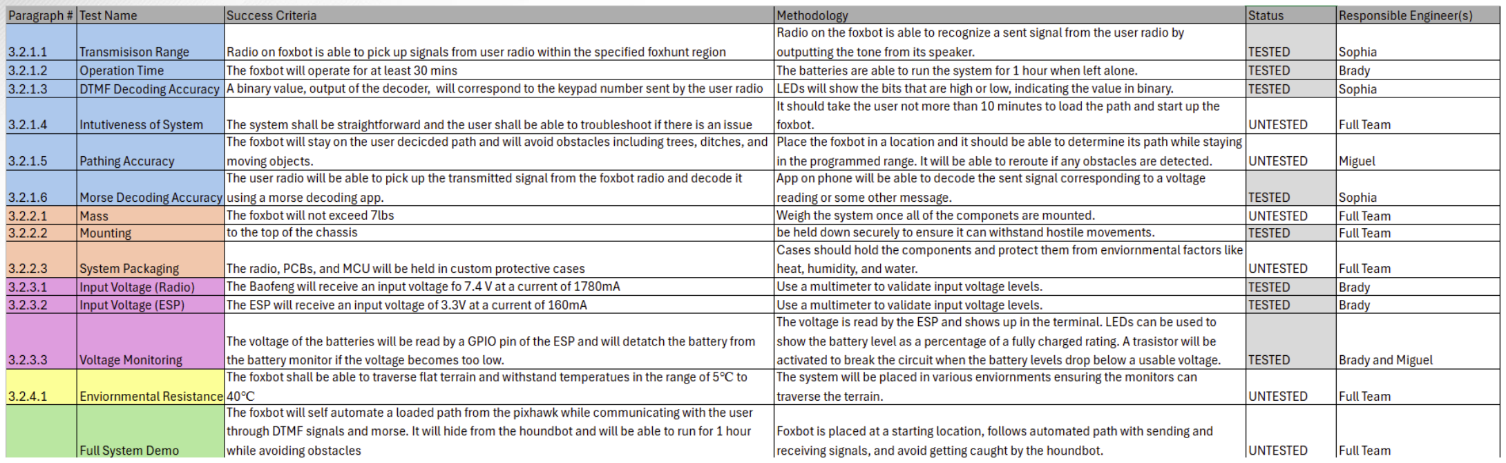
[picture p46: figure]
