segs03-tamu/ECEN404-2025SP-Fantastic-Foxbot/presentation_slides/404 Status Update 5.pdf

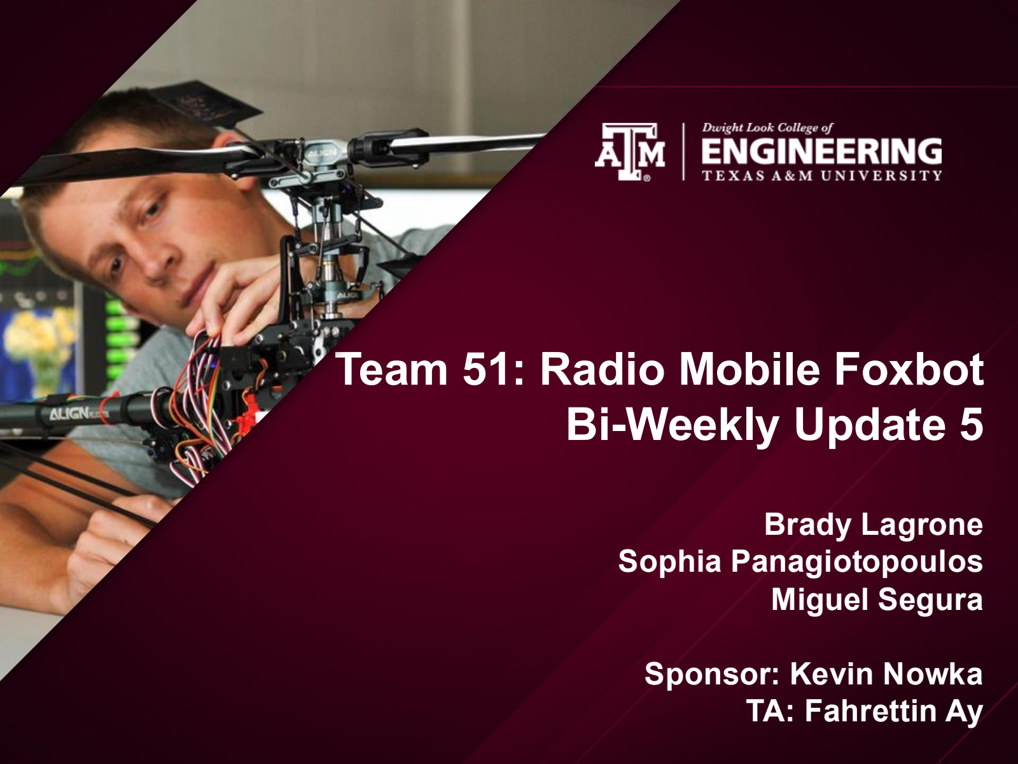
[picture p47: page 1]

# Team 51: Radio Mobile Foxbot Bi-Weekly Update 5

### Brady Lagrone Sophia Panagiotopoulos Miguel Segura

### Sponsor: Kevin Nowka TA: Fahrettin Ay

# Project Summary

### Purpose:

- Amateur Radio Directional Finding (ADRF) is a sport in which an individual tries to locate a hidden transmitting device. Our goal is to “hide” from an adversary Houndbot, who will be trying to locate our robot. Additionally, our robot will increase the potential of ARDF training and aid in the engineering of directional antennas.


### Proposal:

- We have created a radio system coupled with a mobile robot that receives DTMF signals and preforms various functions based on the decoded signal.

# Project Timeline

Subsystem
Designs and
Testing
(completed
01/27)

Integration of
power and
radio
subsystem
PTT
(completed
2/9)

Integration of
MCU and
Motor Driver
(to complete
by 2/14)

Integration of
power and
radio ADC
(to complete
by 2/14)

All systems
have been
integrated
(to complete
by 3/7)

System
Testing (to be
completed
3/17)

Demo and
Report
(to complete
by 4/14)

# Integrated System Diagram

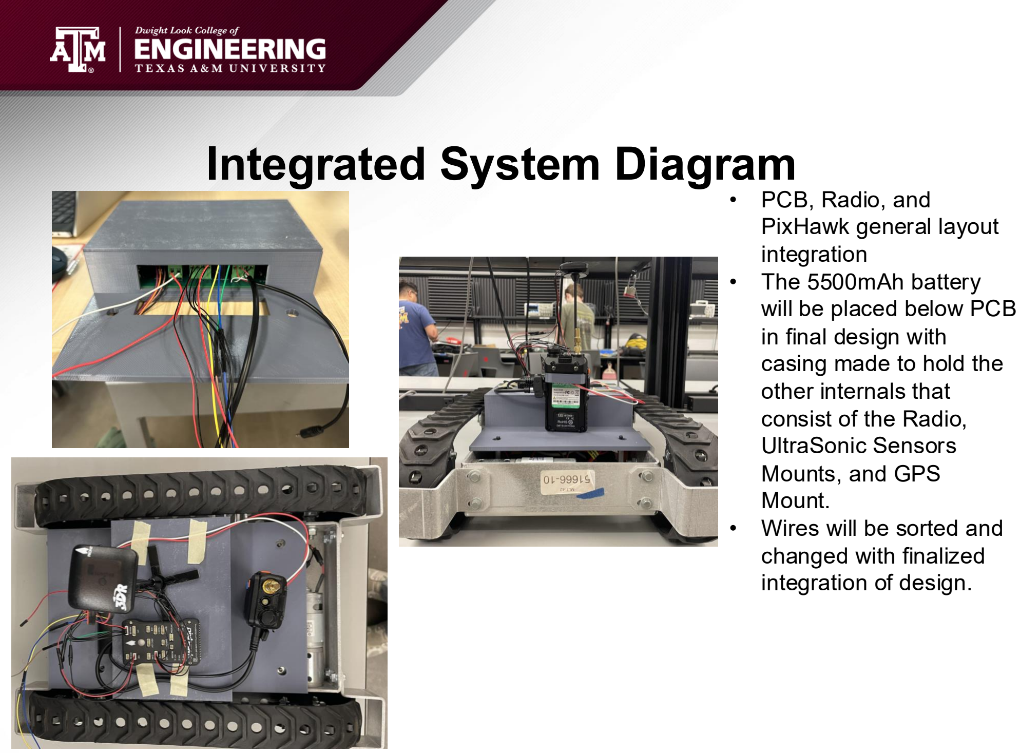
[picture p48: page 4]

- PCB, Radio, and
PixHawk general layout
integration
- The 5500mAh battery
will be placed below PCB
in final design with
casing made to hold the
other internals that
consist of the Radio,
UltraSonic Sensors
Mounts, and GPS
Mount.
- Wires will be sorted and changed with finalized
integration of design.

# Miguel Segura

Accomplishments since last update 42 hrs of effort

Ongoing progress/problems and plans until the next presentation

- PixHawk autopilot system followed the initial basic testing path (March 20th)
- Reconfigured full parameters of new PixHawk
- Configured overall system layout
- Reprogrammed 403 Code to facilitate testing for my groupmates
- Performed rotation tests for Rover to validate motor control using previous code
- Connected new MB1202 Ultrasonic Sensor to PixHawk/Rover
- PixHawk is inconsistent for full navigation autonomous control. Seems to be issues with Compass Magnetic Field.
- Looking to cover motor controller with electromagnetic shielding material and other items that may be affecting the compass.
- Use previously developed motor control code to perform tests for other systems

# Miguel Segura

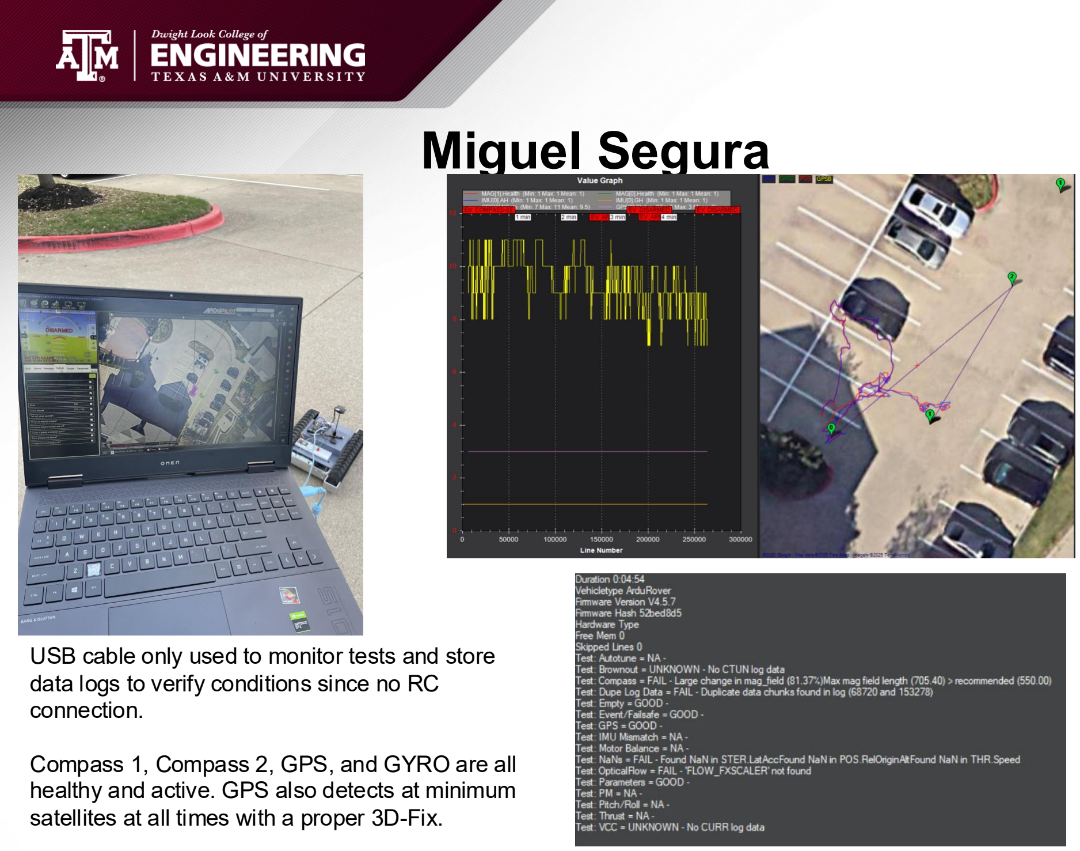
[picture p49: page 6]

USB cable only used to monitor tests and store data logs to verify conditions since no RC connection.

Compass 1, Compass 2, GPS, and GYRO are all healthy and active. GPS also detects at minimum satellites at all times with a proper 3D-Fix.

# Brady Lagrone

Accomplishments since last update 16 hrs of effort

Ongoing progress/problems and plans until the next presentation
- Validated different modes of operation and testing
- PCB configuration
- Alert user DTMF signal was received by the on board radio
- Call sign programed
- Implemented constant
transmitting song
- Radio and ESP integration with Pixhawk pathing and control
- Full system validation

# Brady Lagrone

Modes of Operation:
- Users sends DTMF signal for each
- Need to send heartbeat to pixhawk each mode
- Check Ultrasonic During modes of operation and alert if object
- First mode (Beep on moving on path) ( 20 Seconds)
- Second mode (Emitting signal, pause ”hide”, repeat) (10s, 10s)
- Third Mode (Beep on off Stationary)(20s)
- Fourth Mode (Continuous PTT and stationary) (20s)
- Health mode (Check Bot)
- Battery, GPS, health, ultrasonic check
- Need to have a reset value
- KJ5HZT (call sign)

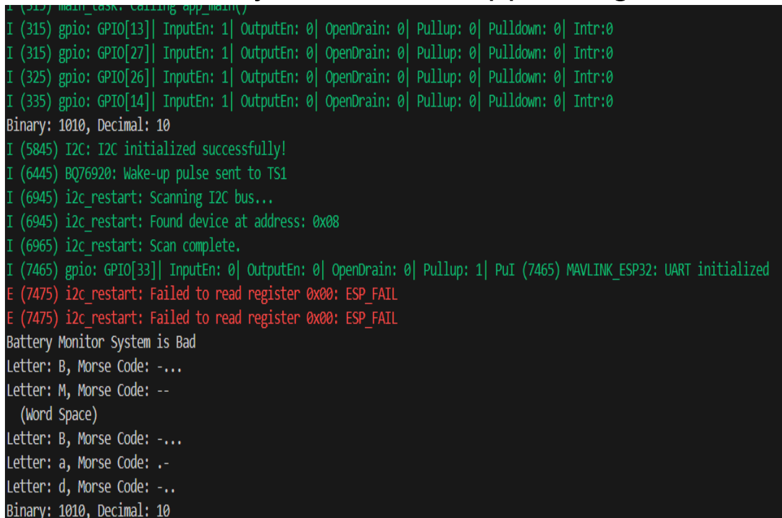
[picture p50: figure]

Simulate Battery monitor not opperating

# Sophia Panagiotopoulos

Accomplishments since last update 20 hrs of effort

Ongoing progress/problems and plans until the next presentation
- Validated system packaging for various environmental factors.
- Tested and validated battery connector between the radio and 7.4V line.
- Validated correct arming and disarming behavior of the
Pixhawk.
- Tested various modes of
operation for transmitting and pathing.
- Continue integrating with motor control to allow different modes of operation.
- Develop validation scenarios for Foxbot health updates.
- Field testing for range and battery life.

# Sophia Panagiotopoulos

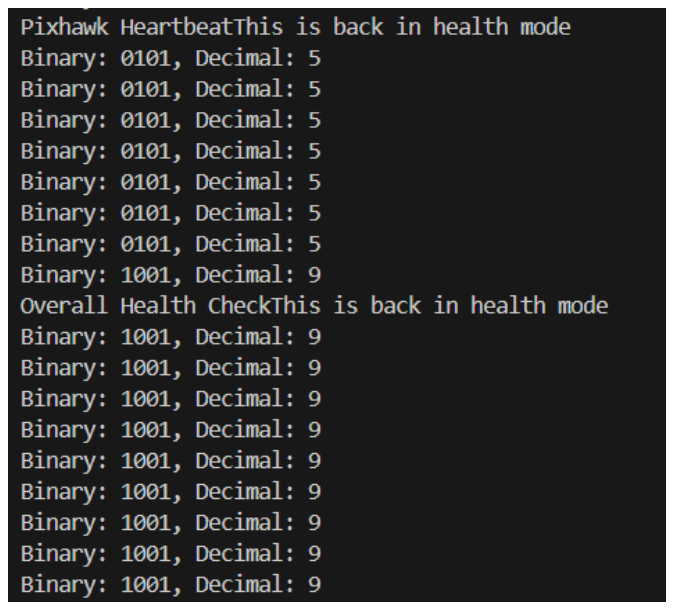
[picture p51: figure]
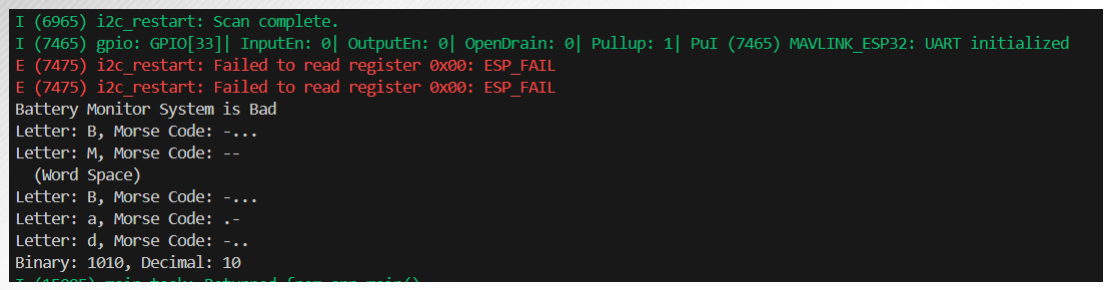
[picture p52: figure]

This shows the initial setup of the system -> bad battery monitor reading will correspond with the Pixhawk not starting its path.

When the system is in 'Health Mode', it will be waiting for a tone to implement that mode's function. When the mode is complete, the system will return to 'Health Mode' and wait for the next task.

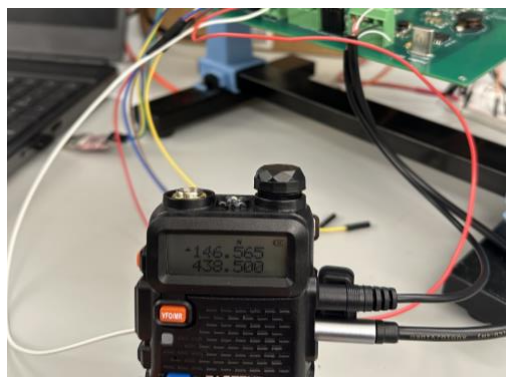
[picture p53: figure]
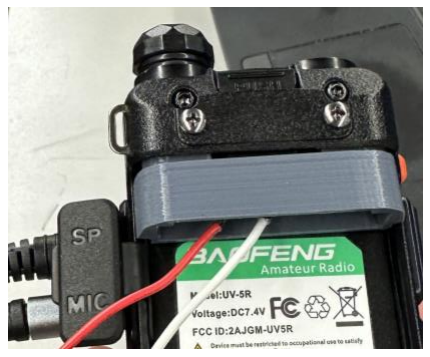
[picture p54: figure]

Radio is powered off the 7.4V line where it performs at full functionality (ptt is turned on and off)

The mode will only be executed once with the next mode being performed after a new binary value is read 3 times.

# Execution Plan

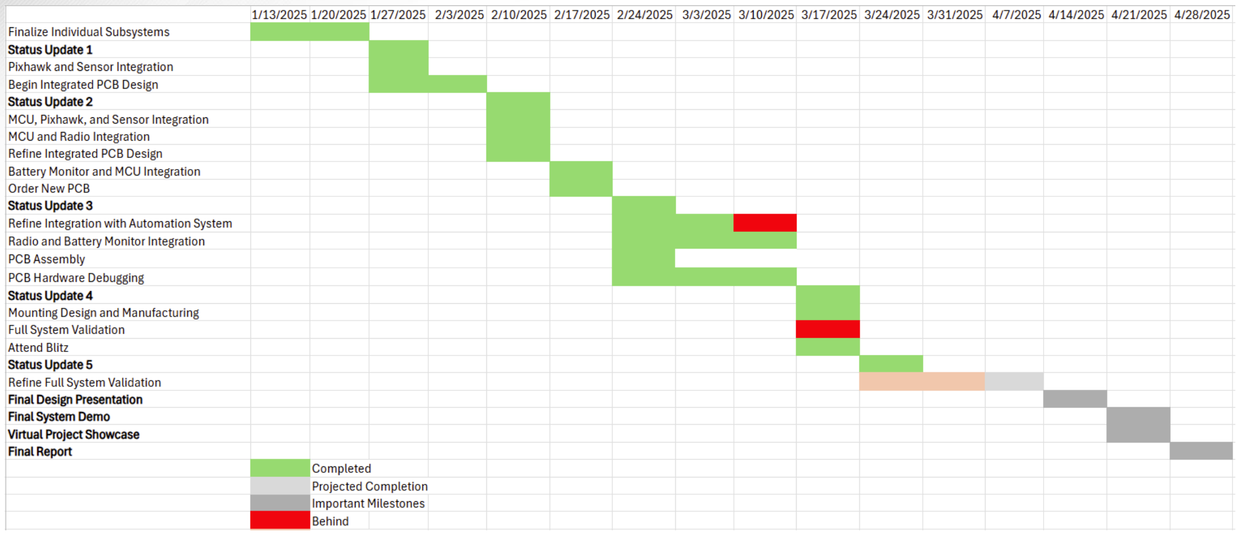
[picture p55: figure]

# Validation Plan

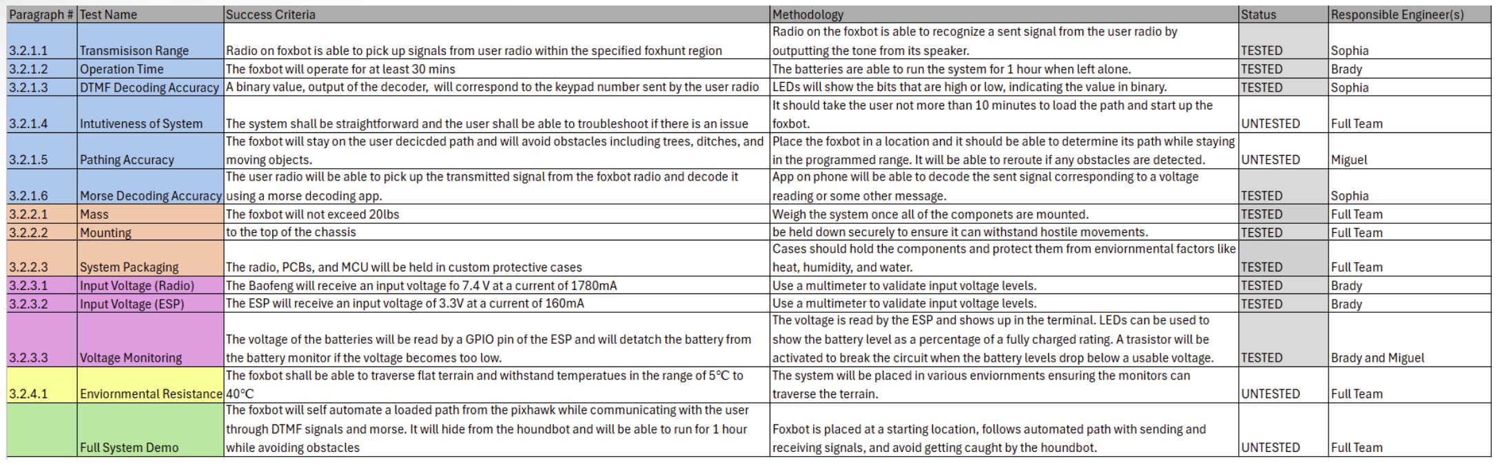
[picture p56: figure]
