segs03-tamu/ECEN404-2025SP-Fantastic-Foxbot/Team#51_PCB/CapStone_BOM.xlsx

Line # | Name | Description | Designator | Revision ID | Revision State | Revision Status | Quantity | Amount
 | TPS565201DDCR | 3.3V Converter | 3.3 |  | Not managed |  | 1 | 1 | 0
 | TPS54308 | 5.3V Converter | 5.3 |  | Not managed |  | 1 | 4 | -3
 | TPS56339DDCR | 7.4V Converter | 7.4V |  | Not managed |  | 1 | 7 | -6
 | 1731857 | Connector | Bat1, Bat2, Bat3, PixHawk_Connector, Radio_Connector |  | Not managed |  | 5 | 6 | -1
 | 1714955 | PC Terminal Block, Pitch 6.35 mm, 1 x 2 Position, Height 21.5 mm, Tail Lenght 5.1 mm, RoHS, Bulk | Battery1, Battery2_IN, Battery2_OUT, Battery3_IN, Battery3_OUT, Walkie_Talkie | CMP-2000-05797-1 | Released | Up to date | 6 | 6 | 0
 | BQ7692003PWR | Battery Mon | BM_1, BM_2, BM_3 |  | Not managed |  | 3 | 3 | 0
 | C3216X7R2E104K160AA | 100nF/0.1uF | C1, C2, C53 | CMP-08246-006636-1 | New From Design | Up to date | 3 | 10 | -7
 | TAJA106K016RNJ | 10uF | C3, C4 | CMP-1661-00004-2 | Released | Up to date | 2 | 3 | -1
 | 12065C105JAZ2A | 1 uF | C5, C7, C8, C9, C10, C11, C16, C18, C19, C20, C21, C22, C27, C29, C30, C31, C32, C33 |  | Not managed |  | 18 | 18 | 0
 | 12065C475K4Z2A | 4.7 uF | C6, C17, C28 |  | Not managed |  | 3 | 5 | -2
 | C3225X7R2A106K250AC | 10uF | C12, C23, C34 |  | Not managed |  | 3 | 8 | -5
 | C1206C104K5RAC7867 | 0.1 uF | C13, C14, C15, C24, C25, C26, C35, C36, C37 |  | Not managed |  | 9 | 15 | -6
 | C3216X5R1E336M160AC | 33uF | C38 | CMP-08246-002728-1 | New From Design | Up to date | 1 | 9 | -8
 | GRM31C5C1H104JA01K | 0.1 uF | C39 | CMP-06035-050440-1 | New From Design | Up to date | 1 | 7 | -6
 | GRM319R72A104KA01D | 0.1 uF | C40 |  | Not managed |  | 1 | 8 | -7
 | TMK325B7226KMHP | 22 uF | C41, C42 | CMP-14477-002449-2 | New From Design | Up to date | 2 | 6 | -4
 | TMK212BJ474KD-T | 0.47 uF | C43 |  | Not managed |  | 1 | 6 | -5
 | 08053C104KAT2A | 0.1 uF | C44 |  | Not managed |  | 1 | 7 | -6
 | C3216X5R1E336M160AC | 33uF | C45 |  | Not managed |  | 1 | 0 | 1
 | C2012X5R1V106K085AC | 10uF | C46, C47 |  | Not managed |  | 2 | 6 | -4
 | GRM32NR72A104KA01L | .1uF | C48 |  | Not managed |  | 1 | 2 | -1
 | C0603C104M3VACTU | Capacitor | C49 |  | Not managed |  | 1 | 0 | 1
 | GRM31CR71A226KE15L | 22 uF | C50, C51, C52 |  | Not managed |  | 3 | 0 | 3
 | A-3.579545-18 | 3.5795MHz OSC | CO1 |  | Not managed |  | 1 | 2 | -1
 | TPSMB75A-L | TVS Diode (Uni-directional) | D1 |  | Not managed |  | 1 | 0 | 1
 | LTST-C190KRKT | LED RED CLEAR CHIP SMD | DL1, DL2, DL3, DL4, DL5, DL6 | CMP-1674-00011-2 | New From Design | Up to date | 6 | 4 | 2
 | MT8870DSR1 | DTMF IC | DTMF Decoder |  | Not managed |  | 1 | 2 | -1
 | ESP32-WROOM-32E-N16 | Integrated Circuit | ESP2 |  | Not managed |  | 1 | 1 | 0
 | SRP1250-7R8M | 7.8uH | L1 |  | Not managed |  | 1 | 2 | -1
 | SRN6045-6R8Y | 6.8uH | L2 |  | Not managed |  | 1 | 1 | 0
 | SDR1806-2R2ML | 2.2uH | L3 |  | Not managed |  | 1 | 1 | 0
 | MMBT2222ALT1G | Integrated Circuit | PTT_Transistor |  | Not managed |  | 1 | 0 | 1
 | CR1206-JW-103ELF | Thick Film Chip Resistors 1206 10kΩ 0.25W 5% 200ppm/°C | R1, R2, R3, R66 | CMP-07231-005593-1 | New From Design | Up to date | 4 | 0 | 4
 | CRCW1206100KFKEA | 100kΩ | R4, R5, R6, R7, R8, R54 | CMP-1014-00736-2 | Released | Up to date | 6 | 17 | -11
 | ERJ8ENF4700V | 470Ω | R9, R10, R11, R12, R13, R65 | CMP-2003-00388-1 | Released | Up to date | 6 | 15 | -9
 | RCC120610K0FKEA | 10kΩ | R14, R15, R20, R21, R27, R33, R34, R39, R45, R46 |  | Not managed |  | 10 | 6 | 4
 | CRCW12101M00FKEAHP | 1Mohms | R16, R28, R40 |  | Not managed |  | 3 | 4 | -1
 | ERA-8AEB102V | 1kΩ | R17, R18, R19, R23, R29, R30, R31, R32, R41, R42, R43, R44, R58, R59, R60, R61, R62, R63, R64 |  | Not managed |  | 19 | 7 | 12
 | RN73C2A100RBTDF | 100Ω | R22, R24, R25, R35, R36, R37, R47, R48, R49 |  | Not managed |  | 9 | 4 | 5
 | ERJ-L14KJ20MU | 0.02Ω | R26, R38, R50 |  | Not managed |  | 3 | 3 | 0
 | RR1220Q-300-D | 30Ω | R51 | CMP-2001-03553-2 | Released | Up to date | 1 | 8 | -7
 | CRCW120682K5FKEA | 82kΩ | R52 | CMP-2003-02404-1 | Released | Up to date | 1 | 8 | -7
 | CRCW120610K0FKEA | 10kΩ | R53, R57 | CMP-2003-04807-2 | New From Design | Up to date | 2 | 6 | -4
 | CRCW120612K7FKEA | 12.7kΩ | R55 | CMP-2003-04851-1 | Released | Up to date | 1 | 7 | -6
 | CRCW120633K2FKEA | 33.2kΩ | R56 | CMP-02407-004792-1 | New From Design | Up to date | 1 | 8 | -7
 | 3-1825910-1 | SWITCH TACTILE SPST-NO 0.05A 24V | SW3, SW4 | CMP-03407-000001-1 | New From Design | Up to date | 2 | 0 | 2
 | 68000-105HTLF | Connector | Ultrasonic Connector |  | Not managed |  | 1 | 0 | 1
 | TSW-103-07-T-S | Connector | USB Connector |  | Not managed |  | 1 | 0 | 1
 | add 1206 0ohm resistors
