segs03-tamu/ECEN404-2025SP-Fantastic-Foxbot/FoxBot PowerSystem.xlsx

Sheet: POWER
System(w/o MC and Motors) | Operating Voltage | Min Voltage | Max Voltage | Opperating Current(mA) | Current designed for (25%) | Notes | Power | Total Power (Watts) | Total Amps (mA) | Capacity Required | Battery?
ESP32 (https://www.mouser.com/datasheet/2/891/esp32_wroom_32e_esp32_wroom_32ue_datasheet_en-1855879.pdf) | 3.3 | 3 | 3.6 | 500 | 625 |  | 1.65 | 20.026 | 3888.5 | 7777
ESP32 (https://www.mouser.com/datasheet/2/891/esp32_wroom_32e_esp32_wroom_32ue_datasheet_en-1855879.pdf) | 3.3 | 3 | 3.6 | 500 | 625 |  | 1.65 |  | 3.8885 |  | 6000 mAh
HC-SR04 (Ultrasonic Sensor) (https://cdn.sparkfun.com/datasheets/Sensors/Proximity/HCSR04.pdf) | 5 |  | 5.5 | 15 | 18.75 |  | 0.075
HC-SR04 (Ultrasonic Sensor) (https://cdn.sparkfun.com/datasheets/Sensors/Proximity/HCSR04.pdf) | 5 |  | 5.5 | 15 | 18.75 |  | 0.075
M8N (GPS) | 5 | 2.7 |  | 150 | 187.5 |  | 0.75
Pixhawk PX4 Flight Controller | 5.3 |  |  | 150 | 187.5 |  | 2.65
Radio Transmission System |  |  |  |  | 0
Baofang(Radio) | 7.4 |  |  | 1780 | 2225 | Standby 75mA, Recption 380mA, Transmission 1.4A | 13.172
MT8870DSR1 | 5 | 2.7 | 5.5 | 0.8 | 1 |  | 0.004
MC and Motors | Operating Voltage | Min Voltage | Max Voltage | Opperating Current(mA) |  | Notes | Power | Current total (Amps) | Total Power (Watts) | Battery(volts) | Capacity(mAh) | Total time
Motor (https://www.superdroidrobots.com/store/product=490) | 24 |  |  | 500 |  | <500 | 12 | 25 | 600 | 22.2 | 2200 | 0.088
Motor (https://www.superdroidrobots.com/store/product=490) | 24 |  |  | 500 |  | <500 | 12
Sabertooth (Motor Controller) (https://www.dimensionengineering.com/datasheets/Sabertooth2x12.pdf) | 24 |  |  | 24000 |  | Min V-6, Max V-24, Current 12A per motor, Max Current 25 amps per motor | 576
FoxBot Battery | Fully charged | Nomial | Fully discharged |  |  |  | Connector (https://www.amazon.com/Pairs-Connector-Female-Silicon-Battery/dp/B07QM1WS2J?hvadid=693311371864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)
 | 12.6 | 11.1 | 9

Sheet: PinOut_ESP32(OLD)
ESP32_1
PINS | Description | Input/Output | Purpose | Connected? | Descrption
1 | GND |  |  | T | Ground
2 | VCC (3.3V) |  |  | T | Ground
3 | Enable |  |  | T | Ground
4 | Sensor_VP
5 | Sensor_VN
6 | IO34 | I/O |  | T | Connect ESP32 tog
7 | IO35 | I/O |  | T | Connect ESP32 tog
8 | IO32 | I/O |  | T | Connect ESP32 tog
9 | IO33 | I/O |  | T | Connect ESP32 tog
10 | IO25
11 | IO26
12 | IO27
13 | IO14
14 | IO12
15 | GND |  |  | T | Ground
16 | IO13
17 | NC |  |  | T | Not Care
18 | NC |  |  | T | Not Care
19 | NC |  |  | T | Not Care
20 | NC |  |  | T | Not Care
21 | NC |  |  | T | Not Care
22 | NC |  |  | T | Not Care
23 | IO15
24 | IO2
25 | IO0 | O | HC_SR04L_TRIG | T | Trigger pin of ultrasonic sensor on left
26 | IO4 | I | HC_SR04L_ECHO | T | Echo pin of ultrasonic sensor on left
27 | IO16 | U2R2RX | SaberTooth_Rx | T | Transmitting pin from Sabertooth to recieving pin of ESP32
28 | IO17 | U2R2TX | SaberTooth_Tx | T | recieving pin from Sabertooth to Transmitting pin of ESP32
29 | IO5 | O | HC_SR04R_TRIG | T | Trigger pin of ultrasonic sensor on right
30 | IO18 | I | HC_SR04R_ECHO | T | Echo pin of ultrasonic sensor on right
31 | IO19
32 | NC
33 | IO21
34 | RXD0 | U0R0RX | PixHawk_Rx | T | Transmitting pin from PixHawk to recieving pin of ESP32
35 | TXD0 | U0R0TX | PixHawk_Tx | T | recieving pin from PixHawk to Transmitting pin of ESP32
36 | IO22
37 | IO23
38 | GND |  |  | T | Ground
39 | GND |  |  | T | Ground
40 | GND |  |  | T | Ground
41 | GND |  |  | T | Ground
42 | GND |  |  | T | Ground
43 | GND |  |  | T | Ground
44 | GND |  |  | T | Ground
45 | GND |  |  | T | Ground
46 | GND |  |  | T | Ground
47 | GND |  |  | T | Ground
ESP32_2
PINS | Description | Input/Output | Purpose | Connected? | Descrption
1 | GND |  |  | T | Ground
2 | VCC (3.3V) |  |  | T | Ground
3 | Enable |  |  | T | Ground
4 | Sensor_VP
5 | Sensor_VN
6 | IO34 | I/O |  | T | Connect ESP32 tog
7 | IO35 | I/O |  | T | Connect ESP32 tog
8 | IO32 | I/O |  | T | Connect ESP32 tog
9 | IO33 | I/O |  | T | Connect ESP32 tog
10 | IO25 |  | Battery_mont_alert | T | Two directional pin not sure what it does tbh
11 | IO26 |  | SDA communication_3 | T | SDA line of Battery Monitior 3
12 | IO27 |  | SCL communication_3 | T | SCL line of Battery Monitior 3
13 | IO14 |  | Battery_mont_trig_3 | T | Triggers the battery monitor to be on
14 | IO12 |  | Battery_mont_alert | T | Two directional pin not sure what it does tbh
15 | GND |  |  | T | Ground
16 | IO13 |  | SDA communication_2 | T | SDA line of Battery Monitior 2
17 | NC |  |  | T | Not Care
18 | NC |  |  | T | Not Care
19 | NC |  |  | T | Not Care
20 | NC |  |  | T | Not Care
21 | NC |  |  | T | Not Care
22 | NC |  |  | T | Not Care
23 | IO15 |  | SCL communication_2 | T | SCL line of Battery Monitior 2
24 | IO2 |  | Battery_mont_trig_2 | T | Triggers the battery monitor to be on
25 | IO0 |  | DAC Radio | T
26 | IO4 |  | Bit0_Radio | T
27 | IO16 |  | Bit1_Radio | T
28 | IO17 |  | Bit2_Radio | T
29 | IO5 |  | Bit3_Radio | T
30 | IO18 |  | Bit4_Radio | T
31 | IO19 |  | Battery_mont_alert | T | Two directional pin not sure what it does tbh | RC Filter?
32 | NC
33 | IO21 |  | SDA communication | T | SDA line of Battery Monitior 1 | Pull up resistors?
34 | RXD0
35 | TXD0
36 | IO22 |  | SCL communication | T | SCL line of Battery Monitior 1 | Pull up resistors?
37 | IO23 |  | Battery_mont_trig_1 | T | Triggers the battery monitor to be on | Maybe able to combine with SCL communication?
38 | GND |  |  | T | Ground
39 | GND |  |  | T | Ground
40 | GND |  |  | T | Ground
41 | GND |  |  | T | Ground
42 | GND |  |  | T | Ground
43 | GND |  |  | T | Ground
44 | GND |  |  | T | Ground
45 | GND |  |  | T | Ground
46 | GND |  |  | T | Ground
47 | GND |  |  | T | Ground

Sheet: ESP32
Input Transient |  |  |  |  |  |  |  | Title | Part | Qty |  | Output: 3.3 V at 1.25 A
Vout Maximum | Vout Minimum | Average Vout @Vin=12.6 | Average Vout @Vin=9.5 | Overshoot Settle Time | Undershoot Settle Time | Overshoot | Undershoot | IC | TPS565201DDCR (https://www.mouser.com/ProductDetail/Texas-Instruments/TPS565201DDCR?qs=1mbolxNpo8cS5Y6DjJObRA%3D%3D) | 1 | U3
3.34 V | 3.33 V | 3.34 V | 3.33 V | 0.01 ms | 0.01 ms | 0.00 V | 0.00 V | Cin | C2012X5R1V106K085AC (https://www.mouser.com/ProductDetail/TDK/C2012X5R1V106K085AC?qs=6JAMGB%252BEdky%252BlYMcTLhFyA%3D%3D) | 2 | C8,C9
 |  |  |  |  |  |  |  | Cout | GRM31CR71A226KE15L (https://www.mouser.com/ProductDetail/Murata-Electronics/GRM31CR71A226KE15L?qs=%2FBLjsTEvPnhfnPGA5Hlk4g%3D%3D) | 3 | C12,C13,C14
 |  |  |  |  |  |  |  | CBST | C0603C104M3VACTU (https://www.mouser.com/ProductDetail/KEMET/C0603C104M3VACTU?qs=jZ42y6hXG8l3LKJr7CVpKA%3D%3D) | 1 | C11
 |  |  |  |  |  |  |  | L1 | SDR1806-2R2ML (https://www.mouser.com/ProductDetail/Bourns/SDR1806-2R2ML?qs=xrpI9KL%2FXvsM6NNo6hRSNQ%3D%3D) | 1 | L3
 |  |  |  |  |  |  |  | RFBB | CRCW120610K0FKEA (https://www.mouser.com/ProductDetail/Vishay-Dale/CRCW120610K0FKEA?qs=ODaLBy2SlZHPHItpfGW8KQ%3D%3D) | 1 | R7
 |  |  |  |  |  |  |  | RFBT | CRCW120633K2FKEA (https://www.mouser.com/ProductDetail/Vishay-Dale/CRCW120633K2FKEA?qs=P3CgbLlNWtNYMigmD%252Bp%252BlA%3D%3D) | 1 | R6
 |  |  |  |  |  |  |  | Cinx | GRM32NR72A104KA01L (https://www.mouser.com/ProductDetail/Murata-Electronics/GRM32NR72A104KA01L?qs=k8CGH%2FeYcNJZjvEBKBbW2g%3D%3D) | 1 | C10
Output Transient
Vout Maximum | Vout Minimum | Average Vout @Iout=0.125 | Average Vout @Iout=1.25
3.37 V | 3.33 V | 3.35 V | 3.33 V
Startup
Startup Time | Vout Average | Inductor Max Current
0.96 ms | 3.33 V | 2.30 A

Sheet: HC-SR04 MSGEQ7PixHawkGPS
InputTransient |  |  |  |  |  |  |  | Title | Part | Qty |  | Output: 5.3 V at 0.4125 A
Vout Maximum | Vout Minimum | Average Vout @Vin=12.6 | Average Vout @Vin=9.5 | Overshoot Settle Time | Undershoot Settle Time | Overshoot | Undershoot | IC | TPS54308DDCR (https://www.mouser.com/ProductDetail/Texas-Instruments/TPS54308DDCR?qs=gt1LBUVyoHl9iRtozvTSQw%3D%3D) | 1 | U2
5.38 V | 5.18 V | 5.29 V | 5.28 V | 0.16 ms | 0.17 ms | 0.10 V | 0.10 V | Cin | TMK212BJ474KD-T (https://www.mouser.com/ProductDetail/TAIYO-YUDEN/TMK212BJ474KD-T?qs=PzICbMaShUcnyRLJVHq5%252BA%3D%3D) | 1 | C5
 |  |  |  |  |  |  |  | Cout | C3216X5R1E336M160AC (https://www.mouser.com/ProductDetail/TDK/C3216X5R1E336M160AC?qs=LcTL%2F5vFEzFIMvFz4LzwTw%3D%3D) | 1 | C7
 |  |  |  |  |  |  |  | L1 | SRN6045-6R8Y (https://www.mouser.com/ProductDetail/Bourns/SRN6045-6R8Y?qs=opBjA1TV901hgVnK%252Bmh76Q%3D%3D) | 1 | L2
 |  |  |  |  |  |  |  | Rfbt | CRCW1206100KFKEA (https://www.mouser.com/ProductDetail/Vishay-Dale/CRCW1206100KFKEA?qs=9Ncj7kJVcvdB8VbXOa7rhA%3D%3D) | 1 | R4
 |  |  |  |  |  |  |  | Cbst | 08053C104KAT2A (https://www.mouser.com/ProductDetail/KYOCERA-AVX/08053C104KAT2A?qs=EihRZLdKnF2GcTBzDkE%2FiQ%3D%3D) | 1 | C6
 |  |  |  |  |  |  |  | Rfbb | CRCW120612K7FKEA (https://www.mouser.com/ProductDetail/Vishay-Dale/CRCW120612K7FKEA?qs=AcN%2F%2F5h%252BSuaesMVtvx%2FxVA%3D%3D) | 1 | R5
Output Transient
Vout Maximum | Vout Minimum | Average Vout @Iout=0.041249999999999995 | Average Vout @Iout=0.4125 | Overshoot Settle Time | Undershoot Settle Time | Overshoot | Undershoot
5.37 V | 5.20 V | 5.29 V | 5.28 V | 0.20 ms | 0.17 ms | 0.08 V | 0.08 V
Startup
Startup Time | Vout Average | Inductor Max Current
4.74 ms | 5.27 V | 3.77 A

Sheet: Baofang
InputTransient |  |  |  |  |  |  |  |  | Output: 7.4 V at 2.225 A |  | Title | Part | Qty
Vout Maximum | Vout Minimum | Average Vout @Vin=12.6 | Average Vout @Vin=9.5 | Overshoot | Undershoot |  |  |  |  |  | IC | TPS56339DDCR (https://www.mouser.com/ProductDetail/Texas-Instruments/TPS56339DDCR?qs=T3oQrply3y%2FnX4YgbxZYZA%3D%3D) | 1 | U1
7.33 V | 7.28 V | 7.32 V | 7.28 V | 0.03 V | 0.03 V |  |  |  |  |  | Cin | C3216X5R1E336M160AC (https://www.mouser.com/ProductDetail/TDK/C3216X5R1E336M160AC?qs=LcTL%2F5vFEzFIMvFz4LzwTw%3D%3D) | 1 | C1
 |  |  |  |  |  |  |  |  |  |  | Cinx | GRM31C5C1H104JA01K (https://www.mouser.com/ProductDetail/Murata-Electronics/GRM31C5C1H104JA01K?qs=MY6wChARw2zUedP3uqe6YA%3D%3D) | 1 | C2
 |  |  |  |  |  |  |  |  |  |  | Rbst | RR1220Q-300-D (https://www.mouser.com/ProductDetail/Susumu/RR1220Q-300-D?qs=U7dmUkNviFtFSDd5jkn08w%3D%3D) | 1 | R1
 |  |  |  |  |  |  |  |  |  |  | Cbst | GRM319R72A104KA01D (https://www.mouser.com/ProductDetail/Murata-Electronics/GRM319R72A104KA01D?qs=aHh07ZX1ACw840PhdyBNvA%3D%3D) | 1 | C3
 |  |  |  |  |  |  |  |  |  |  | L1 | SRP1250-7R8M (https://www.mouser.com/ProductDetail/Bourns/SRP1250-7R8M?qs=P41GyhEsKL6%2Fx3ckwmCxKA%3D%3D) | 1 | L1
 |  |  |  |  |  |  |  |  |  |  | Rfbt | CRCW120682K5FKEA (https://www.mouser.com/ProductDetail/Vishay-Dale/CRCW120682K5FKEA?qs=RBObajmC9bG9ialL%252BIMjPg%3D%3D) | 1 | R2
 |  |  |  |  |  |  |  |  |  |  | Rfbb | CRCW120610K0FKEA (https://www.mouser.com/ProductDetail/Vishay-Dale/CRCW120610K0FKEA?qs=ODaLBy2SlZHPHItpfGW8KQ%3D%3D) | 1 | R3
 |  |  |  |  |  |  |  |  |  |  | Cout | TMK325B7226KMHP (https://www.mouser.com/ProductDetail/TAIYO-YUDEN/TMK325B7226KMHP?qs=sBf%2Fb4nBSlcFBm9KJOCQlw%3D%3D) | 2 | C4, C34
Output Transient
Vout Maximum | Vout Minimum | Average Vout @Iout=0.2225 | Average Vout @Iout=2.225
7.47 V | 7.13 V | 7.72 V | 7.31 V
Startup
Startup Time | Vout Average | Inductor Max Current
4.48 ms | 7.46 V | 3.08 A
Input Transient
IIC3 | xIIC3 | ICinx3 | xICinx3 | IOut3 | xIOut3 | IInductor3 | xIInductor3 | IIn3 | xIIn3 | ICin3 | xICin3 | ISwitch3 | xISwitch3 | ICout3 | xICout3
3.279153 | 2.86 | 0.266272 | 2.86 | 2.203844 | 2.86 | 2.605008 | 2.86 | 7.71474 | 2.86 | 5.816488 | 2.86 | 2.605008 | 2.86 | 0.40292 | 2.86
Output Transient
IOut4 | xIOut4 | IIC4 | xIIC4 | ICout4 | xICout4 | ICinx4 | xICinx4 | ICin4 | xICin4 | ISwitch4 | xISwitch4 | IInductor4 | xIInductor4
2.225 | 2.5 | 3.675675 | 2.5 | 0.787447 | 2.5 | 1.51803 | 2.5 | 0.804384 | 2.5 | 3.012525 | 2.5 | 3.012525 | 2.5
StartUp Transient
IOut1 | xIOut1 | IIC1 | xIIC1 | ICin1 | xICin1 | IIn1 | xIIn1 | ISwitch1 | xISwitch1 | IInductor1 | xIInductor1 | ICinx1 | xICinx1 | ICout1 | xICout1
2.243356 | 6 | 3.525126 | 6 | 364.6412 | 6 | 365.7462 | 6 | 3.081758 | 6 | 3.081842 | 6 | 1.104993 | 6 | 2.345524 | 6

Sheet: Battery Monitor
IC chip | Pins | VCC<= | VBat | # of Cells | Sense Each Battery | Idea | Reason | Are they avaliable?
BQ34Z100 (https://www.ti.com/lit/ds/symlink/bq34z100.pdf?ts=1729002943453) | 14 | 2.75 | 5.5 | Any | F | Moderate | Would require another voltage regualtor. | Y
bq34210-Q1 (https://www.ti.com/lit/ds/symlink/bq34210-q1.pdf?ts=1728935211146) | 14 | 5.5(Regin) | 5.5 | 1 | F | Bad | Requrie some kind of voltage regulator | Y
BQ34Z100-R2 (https://www.ti.com/lit/ds/symlink/bq34z100-r2.pdf?ts=1728922923083) | 14 | 2.75 | 5.5 | Any | F | Moderate | Would require another voltage regualtor. | Y
BQ34110 (http://ti.com/lit/ds/symlink/bq34110.pdf?ts=1728937353006) | 14 | 4.5 |  |  |  | BAD | Need to look more into, figure out programming , not for dischargong | Y
BQ2050H (https://www.ti.com/lit/ds/symlink/bq2050h.pdf?ts=1728991869474) | 16 | 6.5 |  | 1 | F | Good | Need to look more into, figure out programming | Y
BQ2050 (https://www.ti.com/lit/ds/symlink/bq2050.pdf?ts=1729007233618) | 16 | 6.5 |  | 1 | F | Good | Need to look more into, figure out programming. May look at BQ2050H first | Y
bq2040 (https://www.ti.com/lit/ds/symlink/bq2040.pdf?ts=1729007814606) | 16 |  |  |  |  | Good | Need to look more into, figure out programming | Y
bq28400 (https://www.ti.com/lit/ds/symlink/bq28400.pdf?ts=1728925640330) | 20 | 34 | 34 | 2 | T | Moderate | Would need to figure out how to connect the battery properly | N/Y, different type is avaliable (https://www.mouser.com/ProductDetail/Texas-Instruments/BQ29200DRBT?qs=hEBn5lgDlCoXGMNHcYEAng%3D%3D)
BQ20Z70-V160 (https://www.ti.com/lit/ds/symlink/bq20z70-v160.pdf?ts=1729004832471) | 20 | 2.75 | 2.75 | 1 | F | Bad | Would need to figure out how to connect the battery properly | N
BQ27350 (https://www.ti.com/lit/ds/symlink/bq27350.pdf?ts=1729004103705) | 20 | 2.6 | VCC+.3 | 1 | F | Moderate | Requrie some kind of voltage regulator | Y
bq3060 (https://www.ti.com/lit/ds/symlink/bq3060.pdf?ts=1728925659880) | 24 | 34 | 34 | 2,3,4 | T | Moderate | Would need to figure out how to connect the battery properly | N, may have to look into simlar ones (https://www.mouser.com/c/?q=bq3060)
BQ2063 (https://www.ti.com/lit/ds/symlink/bq2063.pdf?ts=1729006420507) | 28 | 3.6 |  | 1 | F | Bad | Would require an extra chip to work | Y
BQ34Z100-G1 (https://www.ti.com/lit/ds/symlink/bq2060a.pdf?ts=1729007793446) | 28 |  |  |  |  | Moderate | Need to look more into, figure out programming | Y
BQ30Z554-R1 (https://www.ti.com/lit/ds/symlink/bq30z554-r1.pdf?ts=1729002620244) | 30 | 25 | 25 | 2,3,4 | T | Bad | require lots of extra circuitry | N
bq3055 (https://www.ti.com/lit/ds/symlink/bq3055.pdf?ts=1728925353268) | 30 | 25 | 25 | 2,3,4 | T | Moderate | Would need to figure out how to connect the battery properly | N
bq3050 (https://www.ti.com/lit/ds/symlink/bq3050.pdf?ts=1728925621040) | 38 | 34 | 34 | 2,3,4 | T | Bad | require lots of extra circuitry, Would need to figure out how to connect the battery properly | Y
BQ20Z80A-V110 (https://www.ti.com/lit/ds/symlink/bq20z80a-v110.pdf?ts=1728926672993) | 38 | 3.6 |  | 1 | F | Bad | Would require an extra chip to work | Y
BQ2084-V150 (https://www.ti.com/lit/ds/symlink/bq2084-v150.pdf?ts=1729005474758) | 38 | 3.6 |  | 1 | T | Bad | Would require an extra chip to work | Y
BQ2084-V143 (https://www.ti.com/lit/ds/symlink/bq2084-v143.pdf?ts=1729005868144) | 38 | 3.6 |  | 1 | F | Moderate | Would require an extra chip to work | Y
BQ20Z80-V102 (https://www.ti.com/lit/ds/symlink/bq20z80-v102.pdf?ts=1729006201063) | 38 | 3.6 |  | 1 | F | Moderate | Would require an extra chip to work | Y
BQ20Z70-V150 |  |  |  |  |  |  |  | N

Sheet: Testing
5.3 V converter
 | Current Output |  |  | Changing input(200mA)
 | Current | Voltage | Load Regulation(%) | Input Voltage | Output | Line Regulation(%)
 | 0 | 5.264 | 0 | 12.6 | 5.222 | 0.7978723404 |  | Line regulation testing | input voltage
 | 50mA | 5.25 | 0.2659574468 | 12.3 | 5.216 | 0.9118541033 | E-Load | Load regulation test
 | 100mA | 5.237 | 0.5129179331 | 12 | 5.215 | 0.9308510638
 | 150mA | 5.222 | 0.7978723404 | 11.7 | 5.215 | 0.9308510638
 | 200mA | 5.21 | 1.025835866 | 11.4 | 5.213 | 0.9688449848
 | 250mA | 5.197 | 1.272796353 | 11.1 | 5.222 | 0.7978723404
 | 300mA | 5.186 | 1.481762918 | 10.8 | 5.221 | 0.8168693009
 | 350mA | 5.179 | 1.614741641 | 10.5 | 5.22 | 0.8358662614
 | 375mA | 5.171 | 1.766717325 | 10.2 | 5.22 | 0.8358662614
 | 400mA | 5.166 | 1.861702128 | 9.9 | 5.22 | 0.8358662614
 |  |  |  | 9.6 | 5.21 | 1.025835866
7.4V Converter
 |  |  |  |  | Current Output |  |  |  |  | Changing input(1 A)
 |  |  |  |  | Current | Voltage | Load Regulation(%) |  |  | Input Voltage | Output | Line Regulation
 |  |  |  |  | 0 | 7.434 | 0 |  |  | 12.6 | 7.324 | 0
 |  |  |  |  | .200mA | 7.344 | 1.210653753 |  |  | 12.3 | 7.325 | 0.01365374113
 |  |  |  |  | .400mA | 7.367 | 0.9012644606 |  |  | 12 | 7.326 | 0.02730748225
 |  |  |  |  | .600 mA | 7.357 | 1.035781544 |  |  | 11.7 | 7.327 | 0.04096122338
 |  |  |  |  | .800 mA | 7.343 | 1.224105461 |  |  | 11.4 | 7.327 | 0.04096122338
 |  |  |  |  | 1 A | 7.329 | 1.412429379 |  |  | 11.1 | 7.328 | 0.0546149645
 |  |  |  |  | 1.2 A | 7.314 | 1.614205004 |  |  | 10.8 | 7.33 | 0.08192244675
 |  |  |  |  | 1.4 A | 7.32 | 1.533494754 |  |  | 10.5 | 7.331 | 0.09557618788
 |  |  |  |  | 1.6 A | 7.31 | 1.668011838 |  |  | 10.2 | 7.332 | 0.109229929
 |  |  |  |  | 1.8 A | 7.282 | 2.044659672 |  |  | 9.9 | 7.333 | 0.1228836701
 |  |  |  |  | 2 A | 7.25 | 2.47511434 |  |  | 9.6 | 7.336 | 0.1638448935
 |  |  |  |  | 2.2 A | 7.25 | 2.47511434
3.3V Converter
 |  |  |  |  | Current Output |  |  |  |  | Changing input (300mA)
 |  |  |  |  | Current | Voltage | Load Regulation(%) |  |  | Input Voltage | Output | Line Regulation
 |  |  |  |  | 0 | 3.301 | 0 |  |  | 12.6 | 3.274 | 0
 |  |  |  |  | 10mA | 3.288 | 0.3938200545 |  |  | 12.3 | 3.273 | 0.03054367746
 |  |  |  |  | 20mA | 3.286 | 0.4544077552 |  |  | 12 | 3.273 | 0.03054367746
 |  |  |  |  | 50mA | 3.283 | 0.5452893063 |  |  | 11.7 | 3.273 | 0.03054367746
 |  |  |  |  | 100mA | 3.279 | 0.6664647077 |  |  | 11.4 | 3.273 | 0.03054367746
 |  |  |  |  | 200mA | 3.273 | 0.8482278098 |  |  | 11.1 | 3.272 | 0.06108735492
 |  |  |  |  | 400mA | 3.266 | 1.060284762 |  |  | 10.8 | 3.272 | 0.06108735492
 |  |  |  |  | 600mA | 3.254 | 1.423810966 |  |  | 10.5 | 3.272 | 0.06108735492
 |  |  |  |  | 800mA | 3.239 | 1.878218722 |  |  | 10.2 | 3.272 | 0.06108735492
 |  |  |  |  | 1A | 3.227 | 2.241744926 |  |  | 9.9 | 3.271 | 0.09163103238
 |  |  |  |  | 1.1A | 3.224 | 2.332626477 |  |  | 9.6 | 3.271 | 0.09163103238
 |  |  |  |  | 1.2A | 3.216 | 2.57497728

Sheet: BQ7692003PWR
Battery Monitor 1 |  |  |  | Battery Monitor 2
Label | Part | Identifier | Value | Label | Part | Identifier | Value
Cap1 | 12065C105JAZ2A (https://www.mouser.com/ProductDetail/KYOCERA-AVX/12065C105JAZ2A) | C16, C18, C22-C25 | 1 uF | Cap1 | 12065C105JAZ2A (https://www.mouser.com/ProductDetail/KYOCERA-AVX/12065C105JAZ2A) | C27, C29, C33, C35-C37 | 1 uF
RegOut | 12065C475K4Z2A (https://www.mouser.com/ProductDetail/KYOCERA-AVX/12065C475K4Z2A) | C17 | 4.7 uF | RegOut | 12065C475K4Z2A (https://www.mouser.com/ProductDetail/KYOCERA-AVX/12065C475K4Z2A) | C28 | 4.7 uF
TS1, TS1GND | RCC120610K0FKEA (https://www.mouser.com/ProductDetail/Vishay-Dale/RCC120610K0FKEA?qs=IS%252B4QmGtzzoGkT4gqT5LqQ%3D%3D) | R13, R14, R44, R44 | 10 kOhm | TS1, TS1GND | RCC120610K0FKEA (https://www.mouser.com/ProductDetail/Vishay-Dale/RCC120610K0FKEA?qs=IS%252B4QmGtzzoGkT4gqT5LqQ%3D%3D) | R24, R25 | 10 kOhm
Cf | C3225X7R2A106K250AC (https://www.mouser.com/ProductDetail/TDK/C3225X7R2A106K250AC) | C15 | 10 uF | Cf | C3225X7R2A106K250AC (https://www.mouser.com/ProductDetail/TDK/C3225X7R2A106K250AC) | C26 | 10 uF
Rf | RN73C2A100RBTDF (https://www.mouser.com/ProductDetail/TE-Connectivity-Holsworthy/RN73C2A100RBTDF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) | R8, R9,R11 | 100 Ohm | Rf | RN73C2A100RBTDF (https://www.mouser.com/ProductDetail/TE-Connectivity-Holsworthy/RN73C2A100RBTDF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) | R19, R20-R22 | 100 Ohm
 | C1206C104K5RAC7867 (https://www.mouser.com/ProductDetail/KEMET/C1206C104K5RAC7867) | C19-C21 | 0.1 uF |  | C1206C104K5RAC7867 (https://www.mouser.com/ProductDetail/KEMET/C1206C104K5RAC7867) | C30-C32 | 0.1 uF
Rc | ERA-8AEB102V (https://www.mouser.com/ProductDetail/Panasonic/ERA-8AEB102V?qs=Ojoo2rCVP9R3RwZw0XjknA%3D%3D) | R15-R18 | 1 kOhm | Rc | ERA-8AEB102V (https://www.mouser.com/ProductDetail/Panasonic/ERA-8AEB102V?qs=Ojoo2rCVP9R3RwZw0XjknA%3D%3D) | R26-R29 | 1 kOhm
 | BQ7692003PWR (https://www.mouser.com/ProductDetail/Texas-Instruments/BQ7692003PWR?qs=%2Fd%252BFzHvH4c1ZYX6sbOSR8w%3D%3D) | U4 |  |  | BQ7692003PWR (https://www.mouser.com/ProductDetail/Texas-Instruments/BQ7692003PWR?qs=%2Fd%252BFzHvH4c1ZYX6sbOSR8w%3D%3D) | U5
 | CRCW12101M00FKEAHP (https://www.mouser.com/ProductDetail/Vishay-Dale/CRCW12101M00FKEAHP?qs=OAzHGkhREL1IfK%252BVtIUJvA%3D%3D) | R30 | 1Mohm |  | CRCW12101M00FKEAHP (https://www.mouser.com/ProductDetail/Vishay-Dale/CRCW12101M00FKEAHP?qs=OAzHGkhREL1IfK%252BVtIUJvA%3D%3D) | R31 | 1Mohm
 | ERJ-L14KJ20MU (https://www.mouser.com/ProductDetail/Panasonic/ERJ-L14KJ20MU?qs=f9DM49H8yrPZrhRZ%252Bef4rQ%3D%3D) | R10 | 0.02ohm
Battery Monitor 3
Label | Part | Identifier | Value
Cap1 | 12065C105JAZ2A (https://www.mouser.com/ProductDetail/KYOCERA-AVX/12065C105JAZ2A) | C39, C41, C45-C48 | 1 uF
RegOut | 12065C475K4Z2A (https://www.mouser.com/ProductDetail/KYOCERA-AVX/12065C475K4Z2A) | C40 | 4.7 uF
TS1, TS1GND | RCC120610K0FKEA (https://www.mouser.com/ProductDetail/Vishay-Dale/RCC120610K0FKEA?qs=IS%252B4QmGtzzoGkT4gqT5LqQ%3D%3D) | R37, R38 | 10 kOhm
Cf | C3225X7R2A106K250AC (https://www.mouser.com/ProductDetail/TDK/C3225X7R2A106K250AC) | C38 | 10 uF
Rf | RN73C2A100RBTDF (https://www.mouser.com/ProductDetail/TE-Connectivity-Holsworthy/RN73C2A100RBTDF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) | R32, R33-R35 | 100 Ohm
 | C1206C104K5RAC7867 (https://www.mouser.com/ProductDetail/KEMET/C1206C104K5RAC7867) | C42-C44 | 0.1 uF
Rc | ERA-8AEB102V (https://www.mouser.com/ProductDetail/Panasonic/ERA-8AEB102V?qs=Ojoo2rCVP9R3RwZw0XjknA%3D%3D) | R39-R42 | 1 kOhm
 | BQ7692003PWR (https://www.mouser.com/ProductDetail/Texas-Instruments/BQ7692003PWR?qs=%2Fd%252BFzHvH4c1ZYX6sbOSR8w%3D%3D) | U6
 | CRCW12101M00FKEAHP (https://www.mouser.com/ProductDetail/Vishay-Dale/CRCW12101M00FKEAHP?qs=OAzHGkhREL1IfK%252BVtIUJvA%3D%3D) | R43 | 1Mohm

Sheet: New Components
TPS565201DDCR | 1
1714955 | 1
12065C105JAZ2A | 1
C3216X5R1E336M160AC | 1
C0603C104M3VACTU | 1
GRM31CR71A226KE15L | 3
TPSMB75A-L | 1
LTST-C190KRKT | 2
MMBT2222ALT1G | 1
CR1206-JW-103ELF | 4
RCC120610K0FKEA | 4
ERA-8AEB102V | 12
RN73C2A100RBTDF | 5
3-1825910-1 | 2
68000-105HTLF | 1
TSW-103-07-T-S | 1
