segs03-tamu/ECEN404-2025SP-Fantastic-Foxbot/(list of files, drawings)

Other design files:
Team#51_PCB/IntegratedSchematicv1.~(30).SchDoc
